Rubydangoday/Project_IOT_clicker/docs/KY_THUAT_CHI_TIET.md

> **Ghi chú bố cục repo Project_IOT_clicker:** tài liệu này viết theo bố cục cũ. Đối chiếu đường dẫn: `db/` → `database/`; `bridge/`, `ingest/`, `common/`, `history/` → `server/bridge/`, `server/ingest/`, `server/common/`, `server/history/`; `huong-dan-su-dung/` → `docs/huong-dan-su-dung/`; `mau/`, `de-thi-test/` → `samples/`; các file START_HERE/UPGRADE/CHANGES → `docs/phien-ban/`. Bản đang dùng là **V3.18**: Remote firmware V3.17 truyền bằng **BLE advertising A6 trên LE 1M** (bộ thu `server/bridge/ble_adv.py`, bộ xử lý `server/ingest/ingest_adv.py`); các mục mô tả `ble_scan.py`/GATT bên dưới là lịch sử.

> **V3.18 — quét LE 1M khi khởi động và sửa SQL gateway:** đọc [START_HERE_ADV18.md](phien-ban/START_HERE_ADV18.md). Máy đang chạy V3.17: chạy `sudo bash deploy/update_adv18.sh`. Giữ nguyên firmware V3.17.

> **V3.17 — sửa lịch phát/nhận advertising:** máy đã chạy V3.16 hãy đọc [START_HERE_ADV17.md](phien-ban/START_HERE_ADV17.md), chạy `deploy/update_adv17.sh` và nạp firmware V3.17. Các mục bên dưới là lịch sử phiên bản.

> **V3.16 — nhánh advertising thử nghiệm:** đọc [START_HERE_ADV16.md](phien-ban/START_HERE_ADV16.md). Cần cập nhật cả firmware và dịch vụ server; có backup/rollback. Kiểm thử 50 danh tính phần mềm không chứng minh tải RF 50 remote.

> **V3.15 — nghỉ khi chờ câu hỏi, giữ BLE:** bắt đầu tại [START_HERE_CONNECTED_IDLE.md](phien-ban/START_HERE_CONNECTED_IDLE.md). Nạp firmware V3.15; server giữ nguyên V3.12. V3.14 bên dưới là hướng dẫn nền về chữ đáp án.

> **V3.14 — đáp án bằng chữ:** bắt đầu tại [START_HERE_LETTER_ANSWERS.md](phien-ban/START_HERE_LETTER_ANSWERS.md). Nạp firmware V3.14; server giữ nguyên V3.12.

> V3.13 tự theo câu giáo viên được giữ trong V3.14. Hướng dẫn nền: [START_HERE_AUTO_QUESTION.md](phien-ban/START_HERE_AUTO_QUESTION.md).

> **V3.12 — phòng theo remote:** đọc [START_HERE_REMOTE_ROOM.md](phien-ban/START_HERE_REMOTE_ROOM.md) cho phần server.

> **V3.11 GATT một remote:** bắt đầu tại [START_HERE_GATT.md](phien-ban/START_HERE_GATT.md). Phần BLE Advertising bên dưới là tài liệu bản cũ.

# ARS server — Hệ thống phản hồi lớp học bằng Remote

Phần mềm chạy trên **laptop giáo viên** (server). Học sinh bấm **Remote nRF52840** (Bluetooth Low Energy), **Bluetooth sẵn có của laptop** thu sóng trực tiếp (không cần gateway); server nhận đáp án, kiểm tra hợp lệ, lưu vào MariaDB và hiển thị trên web giáo viên, màn chiếu, cổng học sinh và phụ huynh.

> Nguyên tắc thiết kế: **Remote và bộ thu Bluetooth chỉ truyền/nhận, không quyết định gì.** Mọi kiểm tra hợp lệ, lưu trữ, thống kê đều nằm ở server (`ingest/ingest.py`). Firmware có thể đơn giản, sửa luật chỉ cần sửa server.

Hướng dẫn sử dụng cho giáo viên, học sinh, phụ huynh và lập trình viên: **[huong-dan-su-dung/](huong-dan-su-dung/README.md)**

Tài liệu khác: [HUONG_DAN_CAI_DAT.md](HUONG_DAN_CAI_DAT.md) (cài đặt chi tiết) · [UPGRADE_V10.md](phien-ban/UPGRADE_V10.md) (LMS, phụ huynh) · [UPGRADE_V11.md](phien-ban/UPGRADE_V11.md) (trường, Cloud, thi đua, Zalo/SMS) · [UPGRADE_V12.md](phien-ban/UPGRADE_V12.md) (Google/Facebook, học sinh tự đăng ký) · [tests/README.md](../tests/README.md)

---

## 1. Kiến trúc tổng quan

```
                         LAPTOP GIÁO VIÊN (server, chạy được offline)
 ┌──────────┐  BLE quảng bá  ┌──────────────────┐  MQTT   ┌──────────────┐  SQL  ┌─────────┐
 │ Remote   │──────────────▶│ Bluetooth laptop │───────▶│  ingest.py   │──────▶│ MariaDB │
 │ nRF52840 │◀──────────────│  ble_scan.py     │◀───────│ kiểm tra gói │◀──────│  `ars`  │
 └──────────┘  beacon        │ (dịch vụ ars-ble)│ STATE   │ soạn STATE   │       └────▲────┘
  (mỗi học sinh 1 cái)       └──────────────────┘         └──────────────┘            │ đọc/ghi
                                                                                ┌────┴─────┐
                                                                                │ Web PHP  │ ◀── trình duyệt GV,
                                                                                │ (Apache) │     màn chiếu, HS, PH
                                                                                └──────────┘
```

Phần cứng chỉ có **Remote nRF52840** (mỗi học sinh một cái). Laptop chạy server **dùng Bluetooth của chính nó** (BlueZ) để nghe gói Remote phát ra và phát beacon trạng thái ngược lại — không cần mạch gateway. (Tuỳ chọn: phòng quá rộng thì cắm thêm một nRF52840 làm gateway USB — `bridge.py`, mục 4.3.)

| Thành phần | Vai trò |
|---|---|
| **Remote nRF52840** | Học sinh nhập số ghế (ID), chọn chữ A–J, bấm OK. Phát gói quảng bá LOGIN / ANSWER (mục 4.1); quét beacon của laptop để bật đèn xanh khi server đã nhận. |
| **ble_scan.py** (dịch vụ `ars-ble`) | Bluetooth laptop ⇄ MQTT, không có logic. Quét gói quảng bá, lọc Manufacturer Data của ARS → JSON → `ars/<room>/resp`; nhận lệnh STATE/ATTEND/OPENMASK/ACKS → phát **4 gói beacon** song song qua BlueZ. `sudo ars ble` in mọi gói nghe được để kiểm tra firmware. |
| **bridge.py** / **gateway.js** (tuỳ chọn) | Chỉ dùng khi có gateway nRF52840 cắm USB: cầu nối serial ⇄ MQTT (`sudo ars gateway usb`), hoặc qua trình duyệt (Web Serial) khi gateway cắm vào máy GV khác. |
| **Mosquitto** | MQTT broker: 1883 (chỉ trong máy), 9001 WebSocket có mật khẩu (qua Apache `/mqtt`, chỉ cho gateway USB tuỳ chọn cắm vào máy giáo viên). Không mở cổng MQTT ra mạng LAN. |
| **ingest.py** | "Trái tim": kiểm tra gói, ghi CSDL, soạn trạng thái gửi ngược cho Remote, tự đóng câu hết giờ. |
| **MariaDB** | Lưu toàn bộ dữ liệu (lớp, câu hỏi, buổi học, đáp án, LMS…). |
| **Web PHP** | Giáo viên điều khiển buổi học, màn chiếu, báo cáo; cổng học sinh / phụ huynh. **Web không nói MQTT**: chỉ ghi DB và tăng `sessions.state_rev`. |

---

## 2. Cây thư mục

```
ars-server/
├── README.md                     Tài liệu này
├── HUONG_DAN_CAI_DAT.md          Hướng dẫn cài đặt & vận hành chi tiết (Ubuntu, Windows, link cố định, Bluetooth / Remote nRF52840)
├── huong-dan-su-dung/            Hướng dẫn sử dụng: giáo viên, học sinh, phụ huynh, lập trình viên (README là mục lục)
├── UPGRADE_V10/V11/V12.md        Ghi chú nâng cấp từng phiên bản (migration, tính năng mới, giới hạn)
├── CHANGES_V10.md                Danh sách file thay đổi ở v10
├── config.ini.example            Mẫu cấu hình: DB, MQTT, room, Bluetooth [ble], cổng serial gateway (tuỳ chọn), uploads (chép thành config.ini)
│
├── firmware/
│   ├── ARS_remote_v3_10/         Firmware Remote nRF52840 (Arduino, Adafruit nRF52): bàn phím, LED 2 số, BLE, nhập ghế bằng MODE
│   ├── PROTOCOL_V3_10.md         Giao thức BLE + lịch radio + so sánh V3.9 → V3.10
│   └── TEST_V3_10.md             Quy trình test radio, tiêu chí PASS/FAIL
├── bridge/
│   ├── ble_scan.py               Bluetooth laptop ⇄ MQTT: quét gói Remote, phát beacon trạng thái (BlueZ). Báo gw/status mỗi 5 s
│   ├── blecodec.py               Định dạng byte trên sóng Remote ⇄ laptop (mã hoá / giải mã, dùng cho cả test)
│   └── bridge.py                 (tuỳ chọn) Gateway nRF52840 USB serial ⇄ MQTT. Tự nối lại khi rút/cắm USB
├── ingest/
│   └── ingest.py                 Nhận gói từ MQTT → kiểm tra → ghi DB → phát STATE/ATTEND/OPENMASK/ACKS
├── common/
│   └── arscfg.py                 Dùng chung cho Python: đọc config.ini, kết nối DB, mã hoá bitmap ghế / mặt nạ câu
├── tools/
│   ├── sim_clickers.py           Giả lập N Remote V3.10 ở tầng MQTT (ACK chính xác, gửi lại, thử tải)
│   ├── ble_txn_report.py         Đọc log serial Remote + journalctl → ACK lần đầu / gửi lại / NACK / UPLINK_MISS / ACK_MISS, PASS/FAIL
│   ├── i18n_wrap.py              Công cụ dịch: bọc chuỗi tiếng Việt bằng t()/te(), liệt kê khoá dịch
│   ├── i18n_collect.py           Duyệt mọi trang trên máy chủ thử, liệt kê chữ tiếng Việt chưa có bản dịch
│   └── i18n_static.py            Quét mã nguồn PHP, liệt kê chữ tiếng Việt chưa có bản dịch
│
├── db/
│   ├── schema.sql                Bảng lõi: teachers, classes, students, devices, question_sets, questions, sessions,
│   │                             session_questions, session_logins, responses, rejected, gateways, VIEW final_answers
│   ├── migrate_002_hocsinh.sql   Cổng học sinh: tài khoản HS, bài ôn tập, lượt luyện tập, sổ câu sai
│   ├── migrate_003_*.sql         Buổi học/bài giảng, cài đặt, nhật ký AI, mã tham gia lớp, trợ lý học tập
│   ├── migrate_004_*.sql         Nhiều giáo viên (quản trị, khoá), kiểu kết nối lớp
│   ├── migrate_005_lms.sql       Trường, kho đề, media câu hỏi, ghép Remote ↔ học sinh, bài tập về nhà, phụ huynh
│   ├── migrate_006_*.sql         Admin trường/lớp hành chính, đồng bộ Cloud, thi đua đổi quà, thông báo Zalo/SMS
│   ├── migrate_007_oauth.sql     Đăng nhập Google / Facebook
│   ├── migrate_008_*.sql         Học sinh tự đăng ký chưa cần lớp
│   ├── migrate_009_language.sql  Ngôn ngữ giao diện theo tài khoản (vi / en)
│   ├── migrate_010_tutor_chats.sql  Trợ lý AI: nhiều cuộc trò chuyện, đánh giá 👍/👎
│   ├── migrate_011_set_finalize.sql Bộ câu hỏi: trạng thái Đang soạn / Đã hoàn tất
│   └── migrate_012_nrf_only.sql     Chỉ dùng phần cứng nRF52840 (mọi lớp kết nối Bluetooth)
│
├── deploy/                       Cài đặt & vận hành trên Ubuntu
│   ├── install_ubuntu.sh         Cài một lệnh: Apache+PHP, MariaDB, Mosquitto, Python libs, chép code vào /opt/ars-server
│   ├── ars                       Lệnh tiện ích: ars status | logs | ble | gateway ble/usb | watch | sim | links | public on/off | backup…
│   ├── ars-watch                 Xem CSDL trực tiếp (gói vào/bị loại) trên terminal
│   ├── ars-ingest.service        systemd: chạy ingest.py
│   ├── ars-ble.service           systemd: chạy ble_scan.py (nhóm bluetooth, tự rfkill unblock)
│   ├── ars-bridge.service        systemd (tuỳ chọn, tắt sẵn): bridge.py cho gateway USB (nhóm dialout)
│   ├── ars-mdns.service/.sh      Quảng bá tên ars.local trong LAN
│   ├── apache-ars.conf           Alias /ars → web/, link ngắn /gv /hs, chặn lib/, proxy WebSocket /mqtt
│   └── mosquitto-ars.conf        2 listener MQTT (1883 nội bộ, 9001 WebSocket có mật khẩu)
│
├── web/                          Ứng dụng web PHP (document root /ars)
│   ├── index.php · register.php · forgot.php · logout.php     Đăng nhập / tạo tài khoản / quên mật khẩu giáo viên
│   ├── portal.php · go.php · privacy.php                       Trang chọn vai trò, link ngắn /gv /hs, chính sách quyền riêng tư
│   ├── oauth.php                 Đăng nhập / đăng ký / liên kết bằng Google hoặc Facebook (cả 3 vai trò)
│   ├── dashboard.php             Tổng quan giáo viên
│   ├── classes.php · class.php   Danh sách lớp; một lớp: học sinh, nhập Excel, mã tham gia, bắt đầu buổi, giao ôn tập
│   ├── session.php               BẢNG ĐIỀU KHIỂN BUỔI HỌC (mở/đóng câu, lưới ghế cập nhật mỗi giây)
│   ├── projector.php             Màn chiếu cho cả lớp (câu hỏi, đồng hồ, biểu đồ khi GV cho hiện)
│   ├── gateway.php               Gateway USB cắm máy GV: Web Serial ⇄ MQTT ngay trong Chrome/Edge
│   ├── sessions.php · results.php · export.php   Lịch sử buổi; kết quả (p, D, phương án nhiễu); xuất Excel
│   ├── devices.php · mapping.php Tình trạng Remote (pin, RSSI, gói trùng) & bộ thu Bluetooth; ghép MAC Remote ↔ ghế học sinh
│   ├── sets.php · set.php · compose.php          Ngân hàng câu hỏi; soạn câu; tách câu từ Word/Excel/PDF + trợ lý AI
│   ├── media.php · question_file.php             Gắn ảnh/audio/video vào câu hỏi; phục vụ tệp có kiểm tra quyền
│   ├── library.php · variants.php                Kho đề dùng chung (riêng/trường/công khai); tạo mã đề đảo câu/phương án
│   ├── set_export.php · set_docx.php · set_print.php · template*.php   Xuất đề Excel/Word/PDF; file mẫu
│   ├── lessons.php · lesson.php · file.php       Buổi học: bài giảng, kiến thức trọng tâm, câu củng cố; tải bài giảng
│   ├── homework.php · homework_grade.php · lms_file.php   Bài tập về nhà; chấm (AI gợi ý); tệp bài làm
│   ├── analytics.php · cohort.php                Báo cáo & ma trận chủ đề; tổng hợp lớp hành chính (GV chủ nhiệm)
│   ├── family.php                Mã mời phụ huynh, nhận xét, khối lớp
│   ├── rewards.php               Thi đua: bảng xếp hạng, cửa hàng quà, duyệt quà
│   ├── school.php · schools.php · teachers.php   Admin trường; quản trị trường; quản trị giáo viên
│   ├── sync.php · notify.php     Đồng bộ lên Cloud; cấu hình & nhật ký Zalo/SMS
│   ├── settings.php · practice_log.php           Cài đặt (AI, đường dẫn, kết nối clicker Bluetooth, Google/Facebook); lịch sử luyện tập HS
│   ├── api/
│   │   ├── state.php             JSON trạng thái buổi học (bảng điều khiển & màn chiếu gọi mỗi giây)
│   │   ├── action.php            Lệnh điều khiển: mở/đóng/chiếu câu, hiện kết quả, giải phóng ghế, kết thúc → tăng state_rev
│   │   ├── qparse.php · qadd.php · ai.php        Tách câu hỏi; thêm câu vào bộ; trợ lý AI soạn câu / tóm tắt
│   │   └── sync.php              Cloud nhận dữ liệu từ server lớp học (xác thực bằng mã đồng bộ)
│   ├── student/                  Cổng học sinh: home, homework, wrong/right (câu sai/đúng), practice/quiz/review,
│   │                             lectures/lecture, lessons (rút kinh nghiệm), tutor + api_tutor (AI), rewards, register…
│   ├── parent/                   Cổng phụ huynh: index (đăng nhập/đăng ký bằng mã mời), home (tiến độ của con)
│   ├── lang/en.php               Từ điển tiếng Anh (khoá = câu tiếng Việt trong mã)
│   ├── lib/                      Thư viện PHP (bị chặn truy cập trực tiếp):
│   │   ├── i18n.php              Đa ngôn ngữ: t()/te(), chọn ngôn ngữ (?lang=en|vi, cookie, theo tài khoản), dịch toàn trang i18n_html()
│   │   ├── bootstrap.php         Cấu hình, PDO, phiên, CSRF, quyền sở hữu lớp/buổi, giao diện chung, bump_state()
│   │   ├── student.php · lms.php Dùng chung cổng HS; bài tập về nhà, tệp, phụ huynh
│   │   ├── stats.php · sheet.php Thống kê buổi học; đọc/ghi .xlsx/.csv không cần thư viện
│   │   ├── qparse.php · qbank.php · extract.php · variants.php   Tách câu, lưu câu, đọc chữ PDF/PPTX/DOCX, mã đề
│   │   ├── ai.php · ai_offline.php · tutor.php   Trợ lý AI (Claude/OpenAI/Ollama hoặc offline); trợ lý học sinh
│   │   ├── school.php · rewards.php · sync.php · notify.php · oauth.php · auth_ui.php   Tính năng v11–v12
│   │   └── settings_links.php    Phần Đường dẫn / Kết nối clicker của trang Cài đặt
│   └── assets/                   CSS/JS: style.css, student.css, control.js (bảng điều khiển), projector.js,
│                                 gateway.js (Web Serial), fx.js (hiệu ứng), capture.js (vẽ/ghi âm), math.js + vendor/ (KaTeX, mqtt.js, qrcode)
│
├── tests/                        Test tích hợp chạy trên CSDL tạm: `bash tests/run_local.sh` (xem tests/README.md)
└── mau/                          Tệp mẫu: đề Word, dữ liệu thử Excel, bài giảng PDF
```

---

## 3. Workflow: từ lúc Remote bấm đến lúc dữ liệu được lưu

### 3.1 Trước buổi học
1. Giáo viên tạo **lớp** với **mã lớp (room, 1–255)** và danh sách học sinh (**số ghế 1–99** = ID học sinh gõ trên Remote).
2. Laptop phải phục vụ đúng room đó: `config.ini → [gateway] room` (dùng cho `ble_scan.py`; khi Remote đổi room thì gói vẫn được chuyển đúng `ars/<room>/resp`, nhưng beacon trạng thái chỉ phát cho room này).
3. Giáo viên bấm **Bắt đầu** → tạo dòng `sessions` (status `running`). Mỗi room chỉ có **một buổi đang chạy**.

### 3.2 Điểm danh (LOGIN)
```mermaid
sequenceDiagram
    participant R as Remote (nRF)
    participant L as Bluetooth laptop (ble_scan.py)
    participant I as ingest.py
    participant D as MariaDB
    R->>L: BLE quảng bá: LOGIN (room, id=ghế, seq), đợt 150 ms
    L->>I: MQTT ars/<room>/resp {"mac","room","type":1,"id",...,"via":"ble","ts"} (QoS 1)
    I->>D: UPSERT devices (pin, RSSI, last_seen)
    I->>D: kiểm tra buổi, ghế, ghép MAC → INSERT session_logins
    I->>L: MQTT ars/<room>/cmd/gw: ATTEND <bitmap>
    L-->>R: beacon ATTEND chứa bitmap điểm danh → Remote thấy bit của mình → báo đã điểm danh
```

### 3.3 Trả lời câu hỏi (ANSWER)
1. GV bấm **Mở câu** trên `session.php` → `api/action.php` ghi `session_questions` (status `open`, `deadline` theo đồng hồ MariaDB `NOW(3)`) → **tăng `sessions.state_rev`**.
2. `ingest.py` (vòng `state_loop`, mỗi 0,3 s) thấy `state_rev` đổi → phát `STATE <room> <qid> 1 <n_options> <bitmap>` + `OPENMASK` → laptop phát beacon → Remote biết câu `qid` đang mở.
3. Học sinh chọn chữ, bấm OK → Remote phát ANSWER (`q` = số thứ tự câu trong bộ, `ans`, `seq` mới) trong một đợt 150 ms.
4. Laptop nghe gói (một hoặc nhiều bản lặp) → `ble_scan.py` → `ars/<room>/resp` → ingest **kiểm tra theo thứ tự**:

   | # | Kiểm tra | Lý do loại (`rejected.reason`) |
   |---|---|---|
   | 1 | Đủ trường, kiểu đúng, MAC 17 ký tự, type 1/2, room 0–255 | `malformed` |
   | 2 | Room có buổi đang chạy | `no_session` |
   | 3 | Gói phải đến qua Bluetooth (`via` = `ble`) | `wrong_link` |
   | 4 | Nếu ghế/MAC đã ghép cố định (mapping.php) thì phải khớp | `mapping_mismatch` |
   | 5 | MAC đã điểm danh, và đúng ghế đã điểm danh | `not_logged_in` · `id_mismatch` |
   | 6 | Câu `q` đã được mở trong buổi | `q_not_open` |
   | 7 | **Gói trùng** (cùng câu, MAC, seq) → bỏ qua, chỉ đếm `devices.pkt_dup` | (không phải lỗi) |
   | 8 | Câu còn mở, chưa quá hạn | `q_closed` · `late` |
   | 9 | Chữ nằm trong số lựa chọn của câu | `bad_option` |
   | 10 | Nếu buổi không cho đổi đáp án: ghế chưa trả lời câu này | `no_change` |

   (LOGIN có thêm: `unknown_seat` ghế không có trong lớp, `seat_taken` ghế đã có máy khác, `mac_bound` máy đã gắn ghế khác.)
5. Hợp lệ → ghi `responses` → bản ghi **ACK chính xác** `(ghế, câu, seq, đáp án, status 0)` của ghế đó, phát ngay trong gói ACKS. Bị loại → bản ghi **NACK** cùng định danh, `status` = mã lý do.
6. Remote thấy bản ghi **khớp đúng ghế + câu + seq + đáp án** → đèn xanh (NACK → đèn đỏ, Serial in lý do). STATE không bao giờ được dùng làm ACK. Không thấy trong 1 s → nghỉ ngẫu nhiên rồi gửi lại **cùng seq** (tối đa 4 lần); server coi là trùng, không ghi 2 lần, chỉ gia hạn ACK.
7. Bảng điều khiển và màn chiếu đọc `api/state.php` mỗi giây → ô học sinh chuyển xanh, biểu đồ cập nhật.
8. Hết giờ: `ingest` tự đóng câu (`status=closed`) và phát STATE `open=0`. GV bấm **Kết thúc buổi** → `sessions.status=ended`.

### 3.4 Lưu trữ
| Bảng | Nội dung |
|---|---|
| `devices` | Mỗi MAC: pin (mV), RSSI, room/ghế gần nhất, lần cuối thấy, tổng gói, gói trùng |
| `session_logins` | Điểm danh: (buổi, ghế, MAC, thời điểm) — duy nhất theo ghế và theo MAC |
| `responses` | **Mọi lượt bấm hợp lệ** (kể cả đổi đáp án): ghế, MAC, seq, chữ, RSSI, thời điểm ms |
| `final_answers` (VIEW) | Đáp án cuối của mỗi ghế cho mỗi câu = lượt có `id` lớn nhất — dùng cho chấm điểm, thống kê |
| `rejected` | Gói bị loại + lý do + bản gốc (gộp 5 bản lặp của một lần bấm thành 1 dòng trong 10 s) |
| `gateways` | Trạng thái bộ thu (Bluetooth laptop / gateway USB) theo room: online, gói/giây, cổng, cập nhật lúc |
| `sessions`, `session_questions` | Buổi học, câu đã mở/đóng, hạn giờ, `state_rev`, `show_result` |

Sau buổi học, kết quả được dùng cho: trang Kết quả, báo cáo/ma trận chủ đề, sổ câu sai của học sinh, điểm thi đua, tin Zalo/SMS cho phụ huynh, đồng bộ lên Cloud (`sync.php`).

---

## 4. Giao thức truyền / nhận

### 4.1 Remote ⇄ Laptop (BLE quảng bá, không kết nối)
- Remote **phát gói quảng bá** (advertising) LOGIN/ANSWER; laptop **quét** (BlueZ, `ble_scan.py`) — không ghép đôi, không kết nối GATT, nên cả lớp gửi cùng lúc được.
- Laptop **phát beacon** (quảng bá non-connectable) chứa trạng thái; mọi Remote cùng quét để biết câu đang mở và đã được nhận chưa.
- Một lần bấm OK = **1 seq**: một đợt quảng bá 150 ms (≈ 6 sự kiện) rồi nghe ACK 1 s; chưa có thì gửi lại cùng seq (tối đa 4 lần). Bấm lần mới → seq tăng (0–255, quay vòng). Chi tiết lịch radio: [firmware/PROTOCOL_V3_10.md](../firmware/PROTOCOL_V3_10.md).
- Định danh Remote = **địa chỉ BLE** của nó → firmware dùng địa chỉ **random static** cố định (mặc định của nRF52840), không bật privacy (địa chỉ đổi liên tục sẽ bị coi là máy khác).
- Dữ liệu nằm trong **Manufacturer Specific Data** (AD type `0xFF`), mã công ty `[ble] company_id` (mặc định `0xFFFF` — mã thử nghiệm), byte đầu `0xA5`. Mã nguồn tham chiếu: `bridge/blecodec.py`.

**Remote → laptop** (9 byte sau mã công ty):

| Byte | Ý nghĩa |
|---|---|
| 0 | `0xA5` (dấu nhận diện ARS) |
| 1 | type: `1` = LOGIN, `2` = ANSWER |
| 2 | room (0–255) |
| 3 | số ghế / ID (1–99) |
| 4 | câu q (1–64; LOGIN: 0) |
| 5 | seq (0–255) |
| 6 | đáp án: `0` = không có, `1`–`10` = A–J (hoặc mã ASCII `'A'`–`'J'`) |
| 7–8 | pin mV, uint16 little-endian (`0` = không đo) |

Ví dụ ghế 7, room 1, câu 3, seq 12, chọn B, pin 2950 mV: company `0xFFFF`, data `A5 02 01 07 03 0C 02 86 0B`.
Trong firmware nRF5 SDK / Zephyr: `BT_DATA(BT_DATA_MANUFACTURER_DATA, {0xFF,0xFF, 0xA5,0x02,0x01,0x07,0x03,0x0C,0x02,0x86,0x0B}, 11)`.

**Laptop → Remote** (beacon, cùng mã công ty; ACKS ưu tiên, STATE/ATTEND/OPENMASK phát thành burst ngắn khi không có ACK):

| Gói | Byte |
|---|---|
| STATE | `A5 10` room qid open(0/1) **n_options** + bitmap 13 byte ghế **đã có đáp án** câu qid |
| ATTEND | `A5 11` room + bitmap 13 byte ghế **đã điểm danh** |
| OPENMASK | `A5 12` room + 8 byte mặt nạ câu đang mở (câu p ở bit p−1) — cho phím ◀ ▶ |
| ACKS | `A5 13` room n + n bản ghi **(ghế, câu, seq, đáp án, status)**, n ≤ 4 — 4 kết quả mới nhất, mỗi ghế hết hạn sau 1,8 s |

Remote chỉ đọc beacon có room trùng room mình nhớ; dùng `n_options` để chặn tại chỗ đáp án vượt số lựa chọn, ATTEND để xác nhận điểm danh, ACKS để xác nhận đúng giao dịch vừa gửi. Phát beacon cần Linux (BlueZ ≥ 5.50); trên Windows/macOS `ble_scan.py` chỉ nghe.

### 4.2 Dữ liệu gói và lệnh trạng thái
**Dạng JSON** (ble_scan.py giải mã ra, hoặc gateway USB in ra mỗi dòng) — đây là dữ liệu ingest nhận:
```json
{"mac":"C4:1A:00:11:22:33","room":1,"type":2,"id":7,"q":3,"seq":12,"ans":"B","batt":2950,"rssi":-61}
```
| Trường | Kiểu | Ý nghĩa |
|---|---|---|
| `mac` | `AA:BB:CC:DD:EE:FF` | Địa chỉ Remote (định danh thiết bị) |
| `room` | 0–255 | Mã lớp Remote đang nhớ |
| `type` | 1 / 2 | 1 = LOGIN (điểm danh), 2 = ANSWER |
| `id` | 1–99 | Số ghế học sinh nhập |
| `q` | 1–64 | Số thứ tự câu trong bộ (LOGIN: 0) |
| `seq` | 0–255 | Số thứ tự lần bấm (5 bản lặp cùng seq) |
| `ans` | `A`–`J` | Chữ đã chọn (LOGIN: rỗng). Phím 1–9 = A–I, 0 = J |
| `batt` | mV | Điện áp pin (cảnh báo dưới `[ingest] low_batt_mv`, mặc định 2600) |
| `rssi` | dBm | Cường độ sóng bộ thu đo được |

**Lệnh trạng thái** ingest gửi xuống (`ars/<room>/cmd/gw`), bộ thu chuyển thành beacon:
| Lệnh | Ý nghĩa |
|---|---|
| `STATE <room> <qid> <open 0/1> <n_options> <13 byte hex>` | Câu đang chiếu, đang mở hay đóng, số lựa chọn, bitmap ghế **đã có đáp án** câu đó |
| `ATTEND <13 byte hex>` | Bitmap ghế **đã điểm danh** |
| `OPENMASK <8 byte hex>` | Các câu đang mở (câu p ở bit p−1) — cho phím ◀ ▶ chuyển câu trên Remote |
| `ACKS <ghế:câu:seq:đáp_án:status,...>` hoặc `ACKS -` | Kết quả chính xác gần nhất (mỗi ghế 1 bản ghi; gói quảng bá giữ 4 bản ghi mới nhất). `status` 0 = nhận, khác 0 = mã lý do NACK |

**Bitmap:** ghế n ở byte `n ÷ 8`, bit `n mod 8`, bit thấp trước, 13 byte = 104 bit (`common/arscfg.py → bitmap_hex`). Ví dụ ghế 1–4 → `1E000000000000000000000000`.
Server phát lại toàn bộ trạng thái khi có thay đổi (≤ 0,3 s) **và định kỳ mỗi 5 s** (`[ingest] state_refresh_s`), nên bộ thu khởi động lại hay mất một lệnh vẫn tự đúng.

### 4.2b Gateway nRF52840 cắm USB (tuỳ chọn)
Phòng quá rộng so với tầm Bluetooth laptop thì cắm thêm một nRF52840 làm gateway (`sudo ars gateway usb`; quay lại: `sudo ars gateway ble`). **115200 baud, 8N1**: gateway in mỗi gói nghe được thành 1 dòng JSON như mục 4.2 (dòng không bắt đầu bằng `{` là log, bị bỏ qua), nhận mỗi lệnh trạng thái 1 dòng và tự phát beacon.

### 4.3 MQTT (bên trong server)
| Topic | Chiều | QoS | Nội dung |
|---|---|---|---|
| `ars/<room>/resp` | ble_scan.py (hoặc bridge/gateway.js) → ingest | 1 | JSON gói như 4.2, thêm `via` (`ble`), `ts` |
| `ars/<room>/cmd/gw` | ingest → ble_scan.py (hoặc bridge/gateway.js) | 1 | Một lệnh STATE / ATTEND / OPENMASK / ACKS |
| `ars/<room>/state` | ingest → mọi bên | 1, **retain** | JSON trạng thái đầy đủ (`qid, open, answered[], attend[], open_positions[], acks, mode, cmds[]`). Bộ thu vừa khởi động đọc bản giữ lại để phát beacon ngay |
| `ars/<room>/live` | ingest → (tuỳ chọn) | 0 | Số đã trả lời, phân bố đáp án |
| `ars/<room>/gw/status` | ble_scan.py / bridge → ingest | 1, retain | `{"online", "port", "pkt_per_s"}` mỗi 5 s (`port` = `bluetooth hci0` hoặc cổng USB); Last Will = offline |

Phần cứng chỉ dùng **Remote nRF52840** nên mọi gói đều đến qua Bluetooth (`ble_scan.py`, hoặc gateway USB tuỳ chọn); MQTT chỉ mở trong máy (1883) và qua WebSocket `/mqtt` có mật khẩu (chỉ cho gateway USB cắm vào máy giáo viên).

### 4.4 Lưu ý khi sử dụng
- **Room phải khớp**: lớp đang học ↔ `[gateway] room` ↔ room Remote nhớ. Sai room → gói bị loại `no_session`. Đổi room: học sinh nhập lại ID trên Remote.
- **Chỉ nhận gói qua Bluetooth**: gói có `"via"` khác `ble` bị loại `wrong_link`.
- **Bluetooth laptop phải bật**: dịch vụ `ars-ble` tự bỏ chặn (`rfkill unblock bluetooth`) và bật adapter; tắt Bluetooth giữa giờ → Remote không gửi được, web báo "Bluetooth laptop: chưa bật". Tầm thu khoảng 10–20 m trong phòng; đặt laptop giữa lớp hoặc dùng gateway USB (mục 4.2b).
- Kiểm tra Remote mới nạp firmware: `sudo ars ble` in mọi gói quảng bá, dòng `→ ARS {...}` là gói đúng định dạng 4.1.
- **Một ID một máy** trong một buổi. Học sinh đổi Remote giữa giờ → GV bấm ô ghế để **giải phóng ID**, rồi học sinh điểm danh lại.
- **Ghép Remote cố định** (Thiết bị → Ghép Remote) chống mượn máy bấm hộ; đổi ghép ngoài giờ học.
- Tỉ lệ **gói trùng cao là bình thường** (mỗi đợt phát khoảng 6 sự kiện quảng bá cùng seq). Nhiều gói `late`/`q_closed` = học sinh bấm sau khi đóng câu.
- Thời gian (mở câu, hạn giờ, nhận gói) đều lấy theo **đồng hồ MariaDB** — web và ingest không lệch giờ nhau.
- (Gateway USB) rút ra cắm lại: bridge tự nối lại sau 2 s và phát lại trạng thái giữ lại. Linux thường là `/dev/ttyACM0` (người dùng dịch vụ cần nhóm `dialout`); Windows là `COMx` — xem `python bridge/bridge.py --list`.
- Bộ câu dùng với Remote tối đa **64 câu** (mặt nạ OPENMASK 8 byte), lớp tối đa **99 ghế**, câu 2–10 lựa chọn (A–J).
- (Gateway USB) qua trình duyệt (`gateway.php`) cần **Chrome/Edge** và trang mở bằng **https hoặc localhost**; giữ tab mở suốt buổi.
- Xem trực tiếp: `ars logs` (gói vào / bị loại), `ars watch`, trang **Thiết bị** (pin, RSSI, lần cuối thấy), bảng "Gói bị server từ chối" trên bảng điều khiển.

---

## 5. Chạy nhanh

**Ubuntu (khuyên dùng):**
```bash
sudo bash deploy/install_ubuntu.sh        # cài/cập nhật; giữ nguyên config.ini và dữ liệu
ars status                                # apache2, mariadb, mosquitto, bluetooth, ars-ingest, ars-ble
sudo ars ble                              # bấm Remote: thấy dòng '→ ARS' là laptop nghe được
```
Mở `http://localhost/gv` (giáo viên) · `http://localhost/hs` (học sinh) · `/ars/parent/` (phụ huynh). Lần đầu tạo tài khoản quản trị.
Link Internet https: `sudo ars public on` (Tailscale Funnel).

**Cập nhật code đã cài:**
```bash
sudo rsync -a --delete --exclude config.ini --exclude .gateway-usb --exclude .git --exclude '__pycache__' ./ /opt/ars-server/
sudo systemctl restart apache2 ars-ingest ars-ble
```
Có migration mới (`db/migrate_00X_*.sql`) thì chạy trước: `mysql -u root -p ars < db/migrate_00X_….sql`.

**Windows / chạy tay:** XAMPP (Apache + MariaDB) + Mosquitto + Python 3.10 (`pip install paho-mqtt pymysql bleak`); tạo CSDL bằng `schema.sql` rồi lần lượt `migrate_002` → `009`; chép `config.ini.example` → `config.ini`; mỗi buổi chạy `python ingest/ingest.py` và `python bridge/ble_scan.py` (Windows chỉ nghe được Remote, không phát beacon — nên chạy server trên Ubuntu). Chi tiết: [HUONG_DAN_CAI_DAT.md](HUONG_DAN_CAI_DAT.md).

**Không có phần cứng:**
```bash
ars sim 30            # hoặc: python3 tools/sim_clickers.py --room 1 -n 30 [--loss 0.3]
```
Mở bảng điều khiển, bấm **Mở câu** — các ô chuyển xanh dần; cuối chạy bộ giả lập in tỉ lệ xác nhận và độ trễ bấm OK → đèn xanh.

**Test:** `bash tests/run_local.sh` (CSDL tạm, không đụng dữ liệu thật).

---

## 6. Ngôn ngữ giao diện (Tiếng Việt / English)

- Giáo viên và phụ huynh chọn **🇻🇳 VI / 🇬🇧 EN** ở thanh trên (hoặc màn đăng nhập). Lựa chọn lưu theo cookie và theo tài khoản (đăng nhập máy khác vẫn giữ). Lần đầu mở, trình duyệt đặt tiếng Anh sẽ thấy tiếng Anh. Cổng học sinh cũng có nút VI / EN.
- Đã dịch: thanh trên, đăng nhập / đăng ký / quên mật khẩu, Tổng quan, Lớp học, trang lớp, bảng điều khiển + màn chiếu (cả JavaScript), Kết quả, cổng phụ huynh, Google/Facebook. Trang chưa dịch hiện tiếng Việt.
- **Ngôn ngữ khác (Google Dịch):** cuối menu ngôn ngữ, dịch máy toàn bộ trang sang mọi ngôn ngữ Google Dịch hỗ trợ (danh sách lấy trực tiếp từ Google, luôn mới). Cần Internet; script Google chỉ tải khi người dùng chọn; nội dung trang (kể cả tên, điểm học sinh) được gửi tới Google — quản trị tắt được ở Cài đặt → Thông tin chung. Chữ cái đáp án, phím Remote, số ghế, tên ARS gắn `translate="no"`.
- Thêm bản dịch: bọc chuỗi bằng `t('…')` / `te('…')` (PHP) hoặc `T('…')` (JS, trong control.js / projector.js); biến dạng `{n}`. `python3 tools/i18n_wrap.py keys web` liệt kê mọi khoá → thêm vào `web/lang/en.php`.
- Dịch toàn trang: khi chọn tiếng Anh, `i18n_html()` lọc HTML trước khi gửi (chữ giữa các thẻ, placeholder/title, confirm) và `assets/i18n.js` dịch chữ do JavaScript chèn vào — cùng từ điển `web/lang/en.php`, số trong câu viết `{n}`. Tìm chữ còn sót: `KEEP=1 bash tests/run_local.sh` rồi `python3 tools/i18n_collect.py /tmp/ars-test.XXXX/smoke.json` (thêm `EN=1` để xem chữ Việt còn sót trên giao diện tiếng Anh).

## V3.18 ADV18 + Cloud/Web (merge 2026-10-15)

This distribution preserves V3.18 Advertising A6/LE 1M and adds Cloud, attendance, parent accounts and teacher verification. **For a running ADV18 server, do not run a wholesale `git pull` + `install_ubuntu.sh` before reading** [`HUONG_DAN_TICH_HOP_V318_CLOUD.md`](phien-ban/HUONG_DAN_TICH_HOP_V318_CLOUD.md). Use `sudo bash deploy/upgrade_web_cloud_v318.sh` from the extracted merged project instead. Existing firmware, BLE bridge, ingest, PHY and HCI service drop-ins are not changed by that upgrade script. Cloud VPS: `install_ubuntu.sh --cloud`.
