Rubydangoday/Project_IOT_clicker/docs/huong-dan-su-dung/hoc-sinh.md

# Hướng dẫn cho học sinh

[← Mục lục](README.md)

## Mục lục
1. [Dùng Remote trên lớp](#1-dùng-remote-trên-lớp)
2. [Đăng nhập trang học sinh](#2-đăng-nhập-trang-học-sinh)
3. [Vào lớp học](#3-vào-lớp-học)
4. [Các mục trong trang học sinh](#4-các-mục-trong-trang-học-sinh)
5. [Bài tập về nhà](#5-bài-tập-về-nhà)
6. [Ôn tập, câu sai và rút kinh nghiệm](#6-ôn-tập-câu-sai-và-rút-kinh-nghiệm)
7. [Trợ lý AI Cú Học](#7-trợ-lý-ai-cú-học)
8. [Thi đua, điểm thưởng và quà](#8-thi-đua-điểm-thưởng-và-quà)
9. [Câu hỏi thường gặp](#9-câu-hỏi-thường-gặp)

---

## 1. Dùng Remote trên lớp

Remote có màn hình 2 số, đèn đỏ/xanh và 14 phím:

| Phím | Dùng để |
|---|---|
| `1/A` … `9/I`, `0/J` | Nhập số ghế; chọn đáp án (1 = A, 2 = B, …, 9 = I, 0 = J) |
| **◀ LEFT** / **▶ RIGHT** | Chuyển giữa các câu thầy cô đang mở |
| **OK** | Gửi (điểm danh hoặc đáp án) |
| **MODE** | Nhập số ghế (bấm MODE hai lần: nhập room) |

**Nhìn màn hình và đèn để biết Remote đang ở chế độ nào:**

| Màn hình | Đèn | Đang ở chế độ |
|---|---|---|
| Số đứng yên, ví dụ `03` | tắt | Bình thường: đang ở **câu 3** |
| `Gh` rồi đến số (hoặc `--`), lặp lại | **xanh** nháy chậm | **Nhập số ghế** (vừa bấm MODE) |
| `Ph` rồi đến số, lặp lại | **đỏ** nháy chậm | **Nhập phòng (room)** (bấm MODE lần nữa) |
| Một **chữ cái nhấp nháy** ở ô trái: `A`, `b`, `C`, `d`, `E`, `F`, `G`, `H`, `I`, `J` | tắt | **Đã chọn đáp án, CHƯA gửi** — bấm OK |
| Chữ cái **đứng yên** | tắt | Đang gửi, chờ máy chủ |
| Quay về số câu | **xanh** chớp | Máy chủ đã nhận đáp án |
| — | **đỏ** chớp | Bị từ chối hoặc không liên lạc được (chữ cái nhấp nháy lại = bấm OK để gửi lại) |

**Điểm danh (đầu giờ)**
1. Gạt công tắc để bật Remote. Remote nhớ số ghế của lần trước và tự điểm danh lại.
2. Lần đầu (màn hình hiện `Gh` / `--`, đèn xanh nháy) hoặc khi đổi chỗ: bấm **MODE**, gõ **số ghế** (thầy cô cho biết, 1–99), bấm **OK**. Bấm MODE rồi OK ngay (không gõ) là điểm danh lại với số ghế cũ.
3. **Đèn xanh** nghĩa là máy chủ đã nhận, bạn đã điểm danh. Lớp dùng room khác 1: bấm MODE hai lần, gõ room thầy cô cho, OK, rồi gõ số ghế, OK.

**Trả lời câu hỏi**
1. Khi thầy cô bấm *Mở câu*, màn hình Remote hiện số câu.
2. Bấm phím đáp án (ví dụ `2/B` để chọn B) — màn hình hiện chữ `b` nhấp nháy — rồi bấm **OK**.
3. **Đèn xanh** nghĩa là đáp án đã được nhận. Nếu thầy cô cho phép đổi đáp án, bạn chọn lại và bấm **OK** trước khi câu đóng.

**Lưu ý**
- Mỗi Remote chỉ dùng cho **một số ghế** trong một buổi. Đổi Remote giữa giờ thì báo thầy cô để giải phóng số ghế.
- Bấm **OK** một lần là đủ: Remote tự gửi lại (tối đa 4 lần) tới khi máy chủ xác nhận đúng lần bấm đó. **Đèn đỏ** là máy chủ từ chối (ví dụ câu đã đóng) hoặc không liên lạc được.
- Bấm sau khi câu đã đóng thì đáp án không được tính.
- Tắt Remote sau giờ học để tiết kiệm pin.

---

## 2. Đăng nhập trang học sinh

Ở nhà hoặc dùng 4G: mở **https://<may-chu>.<tailnet>.ts.net/hs**. Trong lớp (cùng Wi-Fi với máy chủ): `http://ars.local/hs` hoặc quét mã QR thầy cô chiếu.

**Đã có tên trong danh sách lớp:**
- Đăng nhập bằng **MSSV**. **Lần đầu, mật khẩu chính là MSSV**; hệ thống sẽ bắt đổi mật khẩu mới ngay.

**Chưa có tài khoản:**
- Bấm **Tạo tài khoản mới**, nhập MSSV, họ tên, mật khẩu.
- Có **mã tham gia lớp** thì nhập luôn; chưa có thì vào lớp sau.

**Khác:**
- Có thể đăng nhập bằng Google nếu trường đã bật.
- **Quên mật khẩu**: nhờ thầy cô bấm "đặt lại MK" trong danh sách lớp.
- Đổi mật khẩu: bấm ảnh đại diện góc phải → **🔑 Đổi mật khẩu**.
- Nút **VI / EN** ở góc trên đổi tiếng Việt / tiếng Anh.

---

## 3. Vào lớp học

Ở **Tổng quan**, khung **🏫 Vào lớp học**: nhập **mã tham gia lớp** 6 ký tự thầy cô cho (ví dụ `FDDC78`). Mở link dạng `…/hs/FDDC78` hoặc quét QR thì mã được điền sẵn.

Bạn có thể vào nhiều lớp (mỗi môn một lớp). Khi vào lớp, bạn được cấp **số ghế**: đó là số nhập trên Remote.

---

## 4. Các mục trong trang học sinh

Thanh bên trái (trên điện thoại là menu):

| Nhóm | Mục | Nội dung |
|---|---|---|
| Học tập | 🏠 **Tổng quan** | Việc cần làm, điểm các buổi gần đây, phần cần ôn kỹ, bài giảng mới, lớp của tôi |
| | 🏡 **Bài tập về nhà** | Bài thầy cô giao, nộp bài, xem điểm |
| | 📚 **Bài giảng** | File bài giảng từng buổi, xem trực tiếp trên web |
| | 🎯 **Ôn tập** | Bài ôn được giao, ôn câu sai, ôn theo chủ đề, làm lại bài của một buổi |
| | 🦉 **Trợ lý AI** | Hỏi Cú Học về bài học |
| Kết quả của tôi | ❌ **Câu sai** | Câu đã làm sai, đáp án đúng, ghi lý do sai |
| | ✅ **Câu đúng** | Câu đã làm đúng |
| | 📝 **Rút kinh nghiệm** | Nhìn lại từng buổi: điểm, phần yếu, nguyên nhân sai, kế hoạch ôn |
| Cộng đồng | 🏆 **Thi đua** | Bảng xếp hạng, đổi quà, bộ sưu tập avatar |

Góc trên hiện **⭐ điểm thưởng**, **🔥 chuỗi ngày học liên tiếp** và **cấp độ**. Học đều mỗi ngày để giữ chuỗi.

---

## 5. Bài tập về nhà

1. Mở **🏡 Bài tập về nhà**, chọn bài.
2. Làm ngay trên điện thoại hoặc máy tính. Bài có thể gồm:
   - **Trắc nghiệm**: chọn đáp án.
   - **Tự luận**: gõ bài làm, có thể chèn công thức.
   - **Vẽ tay**: vẽ trên khung, bấm **Đính kèm hình vẽ** (**Xóa nét vẽ** để vẽ lại).
   - **Ghi âm**: bấm ghi, rồi **Dừng và đính kèm**.
3. **Lưu nháp** để làm tiếp sau; nhớ **nộp trước hạn**.
4. Trạng thái bài: *Chưa nộp* → *Đã nộp · chờ chấm* → *Đã có điểm*. Khi thầy cô công bố, bạn thấy điểm và nhận xét từng câu.

---

## 6. Ôn tập, câu sai và rút kinh nghiệm

**🎯 Ôn tập**
- **Giáo viên giao**: bài ôn thầy cô giao (bấm **Làm tiếp** nếu đang làm dở).
- **Ôn lại câu sai**: hệ thống hỏi lại các câu bạn sai hoặc bỏ trống.
- **Theo chủ đề**: chọn chủ đề muốn luyện.
- **Làm lại bài của một buổi**: hữu ích khi bạn vắng buổi đó.
- **Lịch sử ôn tập**: các lượt đã làm.

**❌ Câu sai**
- Xem đáp án đúng và lời giải, chọn **nguyên nhân sai**, ghi **ghi chú rút kinh nghiệm**.
- Câu sai được hỏi lại đến khi bạn trả lời đúng; **đúng 2 lần liên tiếp** thì được tính là **"đã thuộc"**.
- Nút **🦉 Hỏi Cú Học vì sao sai** mở trợ lý AI giải thích riêng câu đó.

**📝 Rút kinh nghiệm**: tổng kết từng buổi (điểm của bạn, trung bình lớp, phần yếu theo chủ đề). Có nút **In / lưu PDF**.

---

## 7. Trợ lý AI Cú Học

Mở **🦉 Trợ lý AI**:
- Hỏi bất cứ điều gì về bài học: giải thích lại, cho ví dụ, ra câu hỏi ôn, lập kế hoạch học.
- Chọn phạm vi (**một buổi học** hoặc **tất cả bài đã học**) và **trình độ** để câu trả lời vừa sức.
- Gợi ý nhanh (nút bên dưới khung chat) và mục **Phần cần củng cố** giúp bạn bắt đầu.
- **＋ Trò chuyện mới** mở cuộc trò chuyện mới; các cuộc cũ được lưu ở cột bên trái. **Xoá toàn bộ lịch sử** nếu muốn.

Lưu ý:
- Khi bạn đang làm **bài kiểm tra**, trợ lý **tạm khoá** đến khi nộp bài.
- Cú Học có thể nhầm. Hãy đối chiếu với bài giảng và hỏi thầy cô khi chưa chắc.

---

## 8. Thi đua, điểm thưởng và quà

- Bạn nhận **⭐ điểm** khi trả lời đúng trên Remote và làm bài tập về nhà.
- **Bảng xếp hạng** theo tuần/tháng trong lớp.
- **Đổi quà**: dùng điểm đổi món quà thầy cô đặt trong cửa hàng của lớp; thầy cô xác nhận khi trao.
- **Bộ sưu tập**: đổi điểm lấy avatar, hoặc dùng chữ cái tên.
- Đạt mốc sẽ nhận **huy hiệu** (hiện thông báo 🏅).

---

## 9. Câu hỏi thường gặp

**Bấm OK mà đèn không xanh.**
- Kiểm tra số ghế nhập đúng chưa.
- Kiểm tra câu đã được mở chưa.
- Ngồi gần laptop của thầy cô hơn.
- Nếu vẫn không được, báo thầy cô xem lý do trên bảng điều khiển.

**Báo "ghế đã có máy khác".** Có Remote khác đã điểm danh số ghế của bạn. Báo thầy cô giải phóng ghế.

**Đăng nhập báo "MSSV này chưa có tài khoản".** Bạn chưa có trong danh sách lớp, bấm **Tạo tài khoản mới**.

**Vắng một buổi.** Vào **Ôn tập → Làm lại bài của một buổi**, và xem **Bài giảng** của buổi đó.
