Rubydangoday/Project_IOT_clicker/docs/huong-dan-su-dung/phu-huynh.md

# Hướng dẫn cho phụ huynh

[← Mục lục](README.md)

Trang phụ huynh giúp bạn xem con học thế nào trên lớp: điểm từng buổi, chuyên cần, bài tập về nhà, kiến thức con còn yếu và nhận xét của thầy cô. Phụ huynh **chỉ xem**, không sửa được điểm hay bài làm.

## 0. Đăng nhập bằng số điện thoại (thầy cô cấp tài khoản)

Nếu thầy cô gửi cho bạn **số điện thoại + mật khẩu lần đầu**:
1. Mở trang phụ huynh: **https://<may-chu>.<tailnet>.ts.net/ars/parent/** hoặc link thầy cô gửi.
2. Ô **Số điện thoại hoặc tên đăng nhập**: nhập SĐT của bạn (ví dụ `0912345678`). Ô **Mật khẩu**: nhập mật khẩu trên phiếu.
3. Lần đầu, trang sẽ yêu cầu **đổi mật khẩu**: đặt mật khẩu riêng (từ 8 ký tự, có cả chữ và số), nhập lại một lần nữa rồi bấm **Lưu mật khẩu mới**.
4. Từ lần sau, đăng nhập bằng SĐT và mật khẩu mới. Nếu có nhiều con trong trường mà cùng SĐT phụ huynh, cả hai con đều hiện trong một tài khoản.

Muốn đổi mật khẩu sau này: vào tab **Tài khoản**, mục **Đăng nhập và mật khẩu**, bấm **Đổi mật khẩu**. Quên mật khẩu: nhờ thầy cô **cấp lại mật khẩu**.

Nếu thầy cô gửi **mã mời** thay vì SĐT và mật khẩu, làm theo mục 1 và 2 dưới đây.

## 1. Nhận mã mời

Thầy cô gửi riêng cho bạn một **mã mời** cho từng con:
- Dạng **8 ký tự** (ví dụ `K7PM-3QXA`), kèm **mã QR**; có thể in trên phiếu mời con mang về.
- Mã có hiệu lực **7 ngày** và chỉ dùng **một lần**. Hết hạn thì xin thầy cô mã mới.

## 2. Tạo tài khoản

1. Mở trang phụ huynh: **https://<may-chu>.<tailnet>.ts.net/ars/parent/** (dùng ở nhà, Wi-Fi hay 4G đều được) hoặc link thầy cô gửi. Quét mã QR trên phiếu mời thì mã được điền sẵn.
2. Chọn **Đăng ký bằng mã mời**, nhập:
   - **Mã mời**.
   - **Họ tên**.
   - **Tên đăng nhập**: 3–50 ký tự, không dấu.
   - **Mật khẩu**: từ 10 ký tự trở lên.
3. Bấm **Tạo tài khoản**. Tài khoản tự liên kết với con.

Nếu nhà trường đã bật, bạn có thể **đăng nhập bằng Google** thay cho mật khẩu (vẫn cần mã mời ở lần đầu).

**Có nhiều con hoặc con học nhiều lớp:** đăng nhập, vào tab **Liên kết**, nhập thêm mã mời ở mục **Liên kết thêm con / lớp**.

## 3. Trang theo dõi

Sau khi đăng nhập, tab **Tổng quan** có:

| Mục | Xem được gì |
|---|---|
| 🔔 **Thông báo** | Sau mỗi buổi học / kiểm tra bằng Remote: con **có mặt / vắng / vắng có phép**, kèm điểm khi thầy cô đã công bố. Tin mới được tô màu và có nhãn *mới* |
| 👪 **Con đã liên kết** | Chọn con muốn xem (nếu có nhiều con); hạng trong lớp, tỉ lệ chuyên cần, điểm 3 buổi gần nhất, số bài chưa nộp |
| 📈 **Tiến độ theo ngày / tuần** | Biểu đồ điểm theo thời gian |
| 🗓 **Điểm và chuyên cần trên lớp** | Từng buổi: ngày, bài, có mặt hay vắng, điểm thang 10 |
| 📝 **Bài tập về nhà** | Bài đã giao, hạn nộp, đã nộp chưa, điểm và nhận xét khi thầy cô công bố |
| 🧠 **Kiến thức trên lớp** | Chủ đề con làm tốt / còn yếu, để nhắc con ôn |
| 💬 **Nhận xét giáo viên** | Nhận xét thầy cô gửi riêng cho con |
| 📚 **Tài liệu bài giảng** | Bài giảng các buổi, để cùng con xem lại |

Khi thầy cô sửa điểm danh hoặc công bố điểm bài kiểm tra, thông báo của buổi đó được cập nhật và hiện lại là *mới*. Thông báo trong web luôn miễn phí và không cần Zalo / SMS.

Góc trên có nút **VI / EN** đổi ngôn ngữ.

## 4. Nhận kết quả qua Zalo / SMS

Nếu nhà trường đã bật kênh thông báo, ở mục **📨 Nhận kết quả buổi học**:
1. Chọn **Kênh nhận tin**: Zalo, SMS hoặc *Không nhận*.
2. Nhập **số điện thoại**, bấm **Lưu**.

Nếu mục này báo *"Nhà trường chưa bật kênh thông báo Zalo / SMS"*, bạn vẫn xem đầy đủ trên web.

## 5. Câu hỏi thường gặp

**Mã mời báo hết hạn hoặc không đúng.**
Mã chỉ dùng được một lần trong 7 ngày. Xin thầy cô mã mới. Chữ hoa hay thường, có dấu gạch ngang hay không đều được.

**Quên mật khẩu.**
Nhờ thầy cô cấp **mã mời mới**, rồi đăng ký lại bằng mã đó.

**Không thấy điểm bài tập.**
Thầy cô chưa **công bố** kết quả bài đó. Điểm hiện sau khi công bố.

**Con vắng buổi học.**
Bảng chuyên cần ghi vắng. Con có thể làm lại bài của buổi đó trong mục *Ôn tập* của trang học sinh.
