Rubydangoday/Project_IOT_clicker/hardware/kicad/previews/Schematic.png

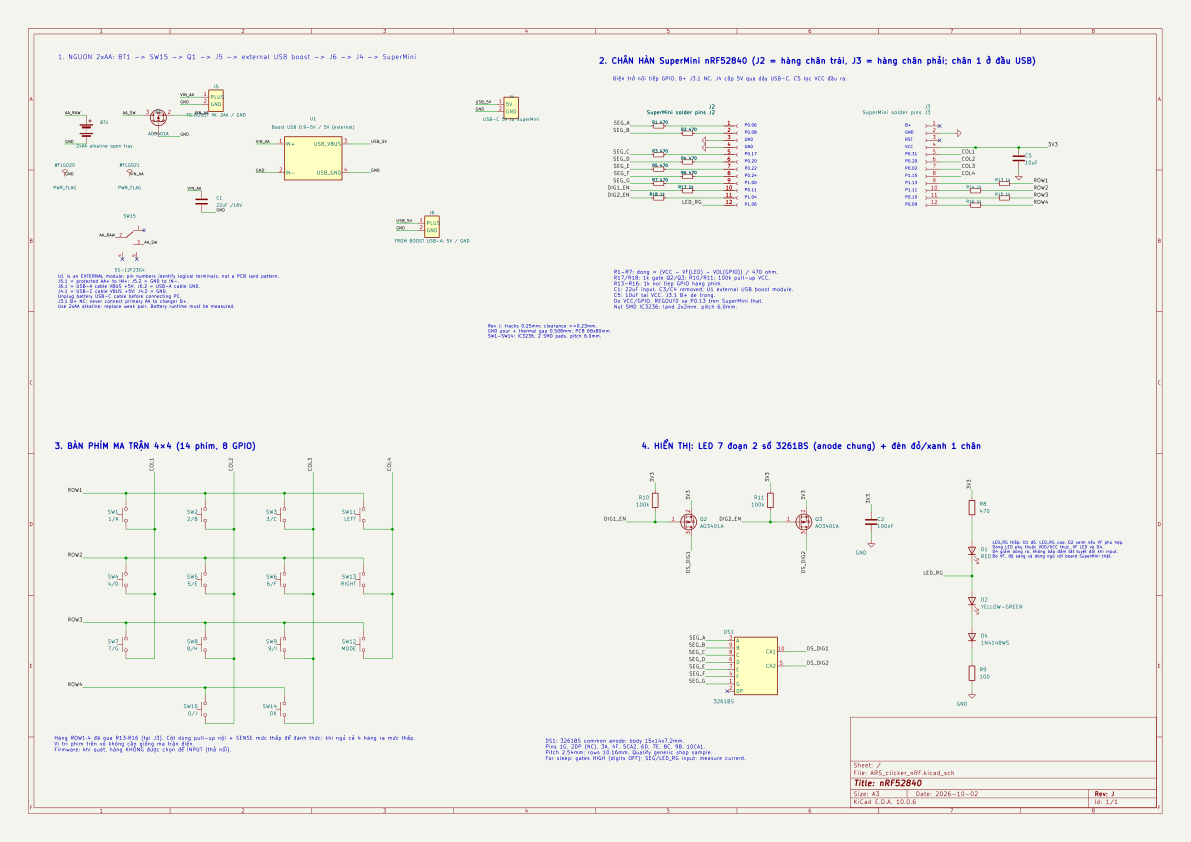
hardware/kicad/previews/Schematic.png
