Rubydangoday/Project_IOT_clicker/hardware/kicad/sources/SW_IC3236_drawing.jpg

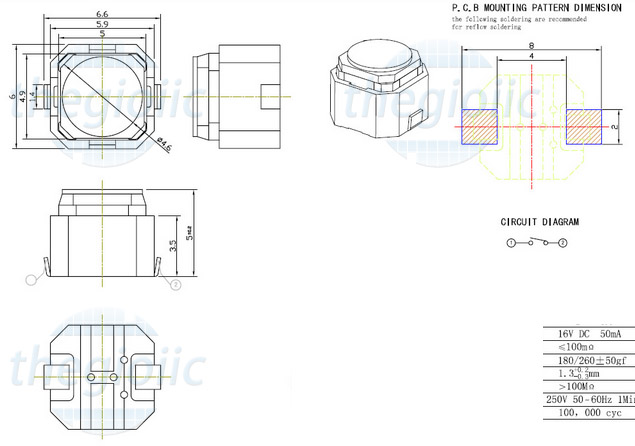
hardware/kicad/sources/SW_IC3236_drawing.jpg
