Rubydangoday/Project_IOT_clicker/hardware/kicad/sources/SW_SS12F23G4_shop_photo.jpg

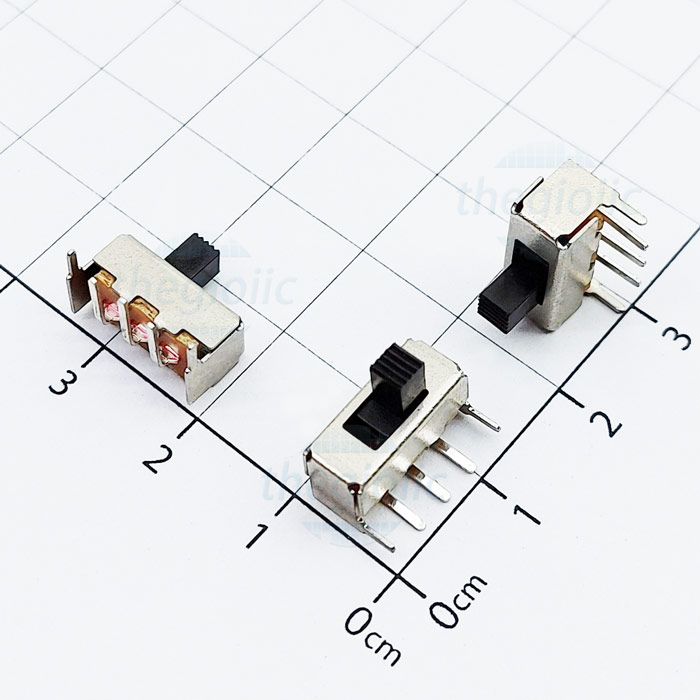
hardware/kicad/sources/SW_SS12F23G4_shop_photo.jpg
