Rubydangoday/Project_IOT_clicker/samples/de-thi-test/Bai_giang_ROS/de_ROS.docx

ĐỀ KIỂM TRA: ROBOT OPERATING SYSTEM

Theo bài giảng: bai-giang/Bai_giang_ROS · 20 câu · 30 giây/câu

Chủ đề: 2. ROS basics

Câu 1: Đơn vị tổ chức mã nguồn cơ bản ("basic cell") của ROS là:

A. Topic

B. Package

C. Launch file

D. Node

Đáp án: B

Giải thích: Package là đơn vị cơ bản; một package có thể chứa nhiều node.

Câu 2: Trong workspace ROS 2, thư mục nào chứa mã nguồn các package?

A. build

B. install

C. src

D. log

Đáp án: C

Giải thích: src: source space; build/install/log do colcon tạo.

Câu 3: Lệnh build workspace ROS 2 là:

A. ros2 build

B. colcon build

C. cmake --build

D. catkin_make

Đáp án: B

Giải thích: ROS 2 dùng colcon build (catkin_make là ROS 1).

Chủ đề: 2. Linux depth

Câu 4: Lệnh Linux nào in ra thư mục làm việc hiện tại?

A. ls

B. mkdir

C. pwd

D. cd

Đáp án: C

Giải thích: pwd – Print Working Directory.

Chủ đề: 2. ROS basics

Câu 5: Lệnh chạy một node trong ROS 2:

A. ros2 node <executable>

B. ros2 run <package> <executable>

C. rosrun <node>

D. ros2 start <node>

Đáp án: B

Giải thích: Ví dụ: ros2 run camera_opencv camera_publisher.

Câu 6: Thư viện client C++ của ROS 2 là:

A. roscpp

B. rclcpp

C. rclpy

D. tf2

Đáp án: B

Giải thích: rclcpp cho C++, rclpy cho Python.

Câu 7: File nào khai báo tên, phụ thuộc (dependencies) của một package ROS 2?

A. package.xml

B. CMakeCache.txt

C. setup.cfg

D. urdf.xml

Đáp án: A

Giải thích: package.xml cho ROS biết package là gì và phụ thuộc vào đâu.

Chủ đề: 3. Define your robot

Câu 8: URDF là định dạng mô tả robot dựa trên:

A. XML

B. YAML

C. CSV

D. JSON

Đáp án: A

Giải thích: Unified Robot Description Format là định dạng XML.

Câu 9: Hai phần tử chính của một mô hình URDF là:

A. link và joint

B. service và action

C. node và topic

D. world và plugin

Đáp án: A

Giải thích: Link: thành phần vật lý; joint: chuyển động tương đối giữa các link.

Câu 10: Thẻ nào trong một link dùng cho tính toán va chạm vật lý?

A. visual

B. inertial

C. collision

D. origin

Đáp án: C

Giải thích: collision dùng cho physics; visual chỉ để hiển thị.

Câu 11: Xacro được dùng để:

A. Điều khiển động cơ

B. Viết URDF gọn hơn bằng macro, chia nhiều file

C. Biên dịch package

D. Mô phỏng cảm biến

Đáp án: B

Giải thích: URDF dài và lặp; xacro cho phép macro, biến, chia file.

Câu 12: Gazebo mô tả model và world bằng định dạng nào?

A. STL

B. URDF

C. SDF

D. YAML

Đáp án: C

Giải thích: Simulation Description Format (SDF).

Chủ đề: 4. ROS Control

Câu 13: Thành phần nào của ros2_control là "phiên dịch" giữa thế giới ROS và phần cứng?

A. Resource Manager

B. Controller Manager

C. Broadcaster

D. Hardware Interface

Đáp án: D

Giải thích: Hardware interface là plugin C++ đọc/ghi phần cứng (read/write).

Câu 14: Thành phần được gọi là "trái tim" của ros2_control, quản lý vòng lặp thời gian thực:

A. URDF

B. Topic

C. Controller Manager

D. Hardware Interface

Đáp án: C

Giải thích: Controller manager quản lý thời gian vòng lặp và nạp/chạy controller.

Câu 15: Controller nào dùng cho robot di chuyển vi sai (differential drive)?

A. joint_state_broadcaster

B. joint_trajectory_controller

C. gripper_controller

D. diff_drive_controller

Đáp án: D

Giải thích: diff_drive_controller nhận cmd_vel, tính vận tốc hai bánh.

Chủ đề: 5. ROS Navigation

Câu 16: Thuật toán định vị robot trên bản đồ trong ROS (dùng particle filter, laser scan) là:

A. A*

B. GMapping

C. AMCL

D. EKF SLAM

Đáp án: C

Giải thích: Adaptive Monte Carlo Localization.

Câu 17: Trong ROS 2 lifecycle node, trạng thái nào là node đang làm việc thực sự?

A. Finalized

B. Unconfigured

C. Inactive

D. Active

Đáp án: D

Giải thích: Unconfigured → Inactive (sẵn sàng) → Active (đang chạy) → Finalized.

Chủ đề: 6. Behaviour Tree

Câu 18: Một node của Behavior Tree trả về những trạng thái nào?

A. Success / Failure / Running

B. True / False

C. Start / Stop

D. Idle / Busy / Error / Done

Đáp án: A

Giải thích: Control node và leaf node đều trả Success, Failure hoặc Running.

Câu 19: Node nào có đúng MỘT con và thay đổi kết quả của con (ví dụ Inverter)?

A. Sequence

B. Fallback

C. Action

D. Decorator

Đáp án: D

Giải thích: Decorator node: một con; Inverter đảo Success ↔ Failure.

Câu 20: So với máy trạng thái hữu hạn (FSM), Behavior Tree có ưu điểm chính là tính mô-đun, dễ mở rộng khi tác vụ phức tạp.

A. Đúng

B. Sai

Đáp án: A

Giải thích: FSM thiếu tính mô-đun, kém hiệu quả khi số tác vụ tăng.
