Rubydangoday/Project_IOT_clicker/samples/de-thi-test/Bai_giang_thiet_ke_robot/de_ROBOT.docx

ĐỀ KIỂM TRA: THIẾT KẾ ROBOT

Theo bài giảng: bai-giang/Bai_giang_thiet_ke_robot · 20 câu · 30 giây/câu

Chủ đề: 2. Tổng quan về TK Robot

Câu 1: Theo bài giảng, thiết kế robot là một quá trình:

A. Tuyến tính, làm một lần

B. Lặp lại và có thoả hiệp

C. Chỉ gồm phần cơ khí

D. Không cần thông số mục tiêu

Đáp án: B

Giải thích: Thiết kế là quá trình lặp lại, là sự thoả hiệp.

Câu 2: Bước 2 của quy trình thiết kế có mục tiêu gì?

A. Bảo trì sau bán hàng

B. Chuyển nhu cầu khách hàng thành thông số kỹ thuật cụ thể

C. Chế tạo mẫu thử

D. Chọn nhà cung cấp

Đáp án: B

Giải thích: Bước 2: Xác định thông số kỹ thuật.

Câu 3: Bước "Hỗ trợ sản phẩm" (bước 5) tập trung vào:

A. Duy trì vận hành và quản lý vòng đời robot sau khi ra mắt

B. Động não phương án

C. Tính bậc tự do

D. Lập kế hoạch dự án

Đáp án: A

Giải thích: Bước 5: hỗ trợ sản phẩm, vòng đời.

Câu 4: Công cụ chính của phương pháp Triển khai Chức năng Chất lượng (QFD) là:

A. Bảng phân phối nguồn

B. Ngôi nhà chất lượng (House of Quality)

C. Biểu đồ Gantt

D. Sơ đồ động học

Đáp án: B

Giải thích: QFD chuyển mong muốn mơ hồ của người dùng thành đặc tính kỹ thuật qua House of Quality.

Câu 5: Phương pháp phân tích dựa trên nhiệm vụ (MBA) xác định thông số mục tiêu từ:

A. Màu sắc sản phẩm

B. Số lượng linh kiện

C. Giá thành đối thủ

D. Kịch bản vận hành cuối cùng của robot

Đáp án: D

Giải thích: MBA dựa trên kịch bản vận hành; ví dụ robot Sojourner của NASA.

Câu 6: Robot nào được dùng làm ví dụ cho phương pháp MBA trong bài giảng?

A. Unitree Go 2

B. NASA Sojourner

C. Boston Dynamics Spot

D. ASIMO

Đáp án: B

Giải thích: NASA’s first Mars rover – Sojourner.

Câu 7: Phương pháp so sánh (benchmarking) dùng để đo chênh lệch giữa robot của mình và đối thủ.

A. Đúng

B. Sai

Đáp án: A

Giải thích: Từ đó đề xuất thông số mục tiêu cạnh tranh.

Chủ đề: 3. Mechanical Design

Câu 8: Ký hiệu trong sơ đồ động học phải theo tiêu chuẩn nào?

A. IP67

B. USB

C. ISO

D. IEEE

Đáp án: C

Giải thích: Các ký hiệu phải theo tiêu chuẩn ISO.

Câu 9: Cơ cấu phẳng chuỗi hở gồm giá cố định và 3 khâu động nối bằng 3 khớp xoay có bao nhiêu bậc tự do?

A. 6

B. 1

C. 2

D. 3

Đáp án: D

Giải thích: Grübler phẳng: M = 3(n − 1) − 2·j1 = 3·3 − 2·3 = 3.

Câu 10: Trên chân robot chó, khâu L1 (hip abduction–adduction) giúp:

A. Đo góc nghiêng

B. Tăng tốc độ chạy

C. Giảm khối lượng pin

D. Chân không va chạm với thân robot

Đáp án: D

Giải thích: L1 giúp chân không va chạm với thân robot.

Câu 11: Diện tích ellipsoid vận tốc của bàn chân càng lớn thì:

A. Động cơ càng nóng

B. Cơ cấu càng kém linh hoạt

C. Cơ cấu càng linh hoạt

D. Không ảnh hưởng

Đáp án: C

Giải thích: Ellipsoid đại diện mức độ linh hoạt của cơ cấu: càng lớn càng tốt.

Câu 12: Trình tự thiết kế chi tiết các khớp chân robot chó là:

A. Đùi → hông → gối

B. Tuỳ ý

C. Hông → đùi → gối

D. Gối → đùi → hông

Đáp án: D

Giải thích: Từ khớp đơn giản tới phức tạp: gối → đùi → hông.

Câu 13: Tiêu chí nào thuộc 3 tiêu chí chọn động cơ trong bài giảng?

A. Màu vỏ động cơ

B. Thương hiệu

C. Kích thước dây

D. Quán tính của tải (load inertia)

Đáp án: D

Giải thích: 3 tiêu chí: mô men xoắn, quán tính tải, tốc độ.

Câu 14: Khớp xoay chạy tốc độ thấp (< 200 rpm) nhưng chịu tải lớn nên chọn:

A. Bạc lót

B. Khớp cầu nhựa

C. Không cần ổ đỡ

D. Ổ bi

Đáp án: A

Giải thích: Ổ bi: tốc độ cao (200–100k rpm); bạc lót: < 200 rpm, chịu tải cao hơn.

Chủ đề: 4. Electronics Design

Câu 15: Điện áp hệ thống điển hình của AGV và robot chó theo bảng thông số mục tiêu:

A. 3,3 – 5 V

B. 24 – 48 V

C. 12 V

D. 220 V xoay chiều

Đáp án: B

Giải thích: AGV, robot chó: 24–48 V; UAV: pin 4S–14S.

Câu 16: Cảm biến nào thuộc nhóm cảm biến trạng thái (đo trạng thái của chính robot)?

A. Camera

B. Lidar

C. Cảm biến siêu âm

D. Encoder bánh xe

Đáp án: D

Giải thích: Cảm biến trạng thái: pin, encoder, IMU; cảm biến môi trường: camera, lidar.

Câu 17: Mạch buck converter dùng để:

A. Đảo chiều động cơ

B. Hạ áp cho từng nhánh nguồn

C. Tăng áp

D. Sạc pin không dây

Đáp án: B

Giải thích: Bước 2 tính toán nguồn: chọn mạch hạ áp (buck) cho từng nhánh.

Câu 18: Robot tiêu thụ dòng trung bình 5 A, cần chạy 4 giờ. Dung lượng pin tối thiểu (bỏ qua hao hụt):

A. 1,25 Ah

B. 20 Ah

C. 9 Ah

D. 40 Ah

Đáp án: B

Giải thích: Dung lượng = dòng trung bình × thời gian = 5 A × 4 h = 20 Ah.

Câu 19: Băng ISM 2,4 GHz là viết tắt của:

A. International Standard Modulation

B. Integrated System Module

C. Internet, Sensor and Mobile

D. Industry, Science and Medical

Đáp án: D

Giải thích: ISM: Industry, Science and Medical, 2,4–2,4835 GHz.

Câu 20: Quan hệ giữa tần số f và bước sóng λ của sóng RF (c là tốc độ ánh sáng):

A. λ = f / c

B. λ = c / f

C. λ = c · f

D. λ = 1 / (c · f)

E. λ = c + f

Đáp án: B

Giải thích: λ = c / f: tần số càng cao bước sóng càng ngắn.
