Rubydangoday/Project_IOT_clicker/samples/de-thi-test/Bai_giang_RTOS/de_RTOS.docx

ĐỀ KIỂM TRA: HỆ THỐNG THỜI GIAN THỰC

Theo bài giảng: bai-giang/Bai_giang_RTOS · 20 câu · 30 giây/câu

Chủ đề: 1. Introduction

Câu 1: Một hệ thống thời gian thực được coi là đúng khi:

A. Chạy càng nhanh càng tốt

B. Kết quả đúng logic và đúng thời điểm (đáp ứng deadline)

C. Không có ngắt

D. Dùng hệ điều hành Linux

Đáp án: B

Giải thích: Correctness phụ thuộc cả kết quả logic lẫn thời điểm tạo ra kết quả.

Câu 2: Real-time computing tương đương với tính toán:

A. Dự đoán được (predictable)

B. Tiết kiệm năng lượng

C. Nhanh nhất có thể

D. Song song

Đáp án: A

Giải thích: Myth: real-time = fast. Truth: real-time = predictable.

Chủ đề: 2. RT system model

Câu 3: Trong hệ thời gian thực cứng (hard real-time), lỡ một deadline thì:

A. Chỉ giảm chất lượng dịch vụ

B. Chấp nhận được nếu hiếm

C. Hệ thống bị coi là sai

D. Tác vụ được chạy lại sau

Đáp án: C

Giải thích: Hard deadline: mọi deadline phải được đáp ứng.

Chủ đề: 1. Introduction

Câu 4: Task là đơn vị công việc nhỏ nhất có thể lập lịch.

A. Đúng

B. Sai

Đáp án: A

Giải thích: Task is the smallest schedulable unit of work.

Chủ đề: 2. RT system model

Câu 5: Loại task nào có các job lặp lại đều đặn theo chu kỳ?

A. Sporadic

B. Aperiodic

C. Periodic

D. Background

Đáp án: C

Giải thích: Periodic task: job được thực thi lặp lại theo chu kỳ cố định.

Câu 6: Task đến không đều nhưng có deadline cứng gọi là:

A. Sporadic task

B. Aperiodic task

C. Periodic task

D. Idle task

Đáp án: A

Giải thích: Sporadic: đến bất thường, deadline cứng; aperiodic: deadline mềm hoặc không có.

Câu 7: Ký hiệu C_i trong mô hình task là:

A. Thời gian thực thi xấu nhất (WCET)

B. Chu kỳ

C. Deadline tương đối

D. Thời điểm phát hành

Đáp án: A

Giải thích: Execution time C_i: thường lấy WCET.

Chủ đề: 3. Clock-driven scheduling

Câu 8: Các task có chu kỳ 4, 5, 20, 20. Hyperperiod H bằng:

A. 4

B. 400

C. 20

D. 10

Đáp án: C

Giải thích: H = bội chung nhỏ nhất (LCM) các chu kỳ = 20.

Câu 9: Lập lịch theo đồng hồ (clock-driven) phù hợp nhất với hệ thống:

A. Xác định trước, tham số mọi task periodic đã biết

B. Đa lõi không đồng bộ

C. Tham số task thay đổi liên tục

D. Nhiều task aperiodic

Đáp án: A

Giải thích: Bảng lịch tính offline cho hệ deterministic.

Câu 10: Ràng buộc kích thước khung (frame) f trong clock-driven scheduling:

A. f tuỳ ý

B. f không nhỏ hơn thời gian thực thi lớn nhất max(C_i)

C. f nhỏ hơn mọi C_i

D. f bằng hyperperiod

Đáp án: B

Giải thích: Mỗi job phải chạy xong trong một khung: f ≥ max(C_i); f còn phải chia hết H.

Chủ đề: 4. Priority-driven scheduling

Câu 11: Rate Monotonic Scheduling (RMS) gán độ ưu tiên theo:

A. Deadline tuyệt đối

B. Chu kỳ: chu kỳ ngắn hơn → ưu tiên cao hơn

C. Thứ tự đến

D. Thời gian thực thi dài hơn → ưu tiên cao hơn

Đáp án: B

Giải thích: RMS: the shorter the period, the higher the priority.

Chủ đề: 4. Priority-driven scheduling (cont)

Câu 12: Deadline Monotonic Scheduling (DMS) gán ưu tiên cao hơn cho task có:

A. WCET lớn hơn

B. Slack lớn hơn

C. Chu kỳ dài hơn

D. Deadline tương đối ngắn hơn

Đáp án: D

Giải thích: DMS: relative deadline ngắn hơn → ưu tiên cao hơn.

Chủ đề: 4. Priority-driven scheduling

Câu 13: Khi số task n rất lớn, giới hạn hiệu suất Liu & Layland của RMS xấp xỉ:

A. 50%

B. 69,3%

C. 82,8%

D. 100%

Đáp án: B

Giải thích: U ≤ n(2^(1/n) − 1) → ln 2 ≈ 0,693.

Câu 14: Ba task T1(4,1), T2(5,2), T3(20,5) (chu kỳ, WCET). Tổng hiệu suất U là:

A. 0,75

B. 0,90

C. 0,85

D. 1,10

Đáp án: B

Giải thích: U = 1/4 + 2/5 + 5/20 = 0,25 + 0,40 + 0,25 = 0,90 (vượt giới hạn L&L 0,78 nhưng RTA vẫn lập lịch được).

Chủ đề: 4. Priority-driven scheduling (cont)

Câu 15: Earliest Deadline First (EDF) ưu tiên task có:

A. WCET nhỏ nhất

B. Deadline tuyệt đối sớm nhất

C. Slack nhỏ nhất

D. Chu kỳ ngắn nhất

Đáp án: B

Giải thích: EDF là thuật toán ưu tiên động phổ biến nhất.

Câu 16: Trên một bộ xử lý, task độc lập, có chiếm quyền, D_i = p_i: EDF lập lịch được khi và chỉ khi:

A. U ≤ 1

B. U ≤ 0,828

C. U ≤ 0,693

D. U ≤ 2

Đáp án: A

Giải thích: EDF tối ưu: schedulable iff U ≤ 1.

Câu 17: Thuật toán Least Slack Time First (LST) ưu tiên task có:

A. Slack (laxity) nhỏ nhất

B. Deadline muộn nhất

C. Chu kỳ dài nhất

D. Slack lớn nhất

Đáp án: A

Giải thích: LST cùng điều kiện như EDF, ưu tiên laxity nhỏ nhất.

Chủ đề: 4. Priority-driven scheduling

Câu 18: Khi chiếm quyền (preemption), hệ điều hành phải làm gì với task đang chạy?

A. Xoá task

B. Khởi động lại CPU

C. Lưu ngữ cảnh (context) rồi chuyển sang task ưu tiên cao

D. Chờ task chạy xong

Đáp án: C

Giải thích: Context switch: lưu thanh ghi/ngăn xếp của task bị chiếm quyền.

Chủ đề: 5. Aperiodic and sporadic tasks

Câu 19: Background scheduling chạy job aperiodic khi nào?

A. Ngay khi job đến

B. Chỉ khi không còn job periodic/sporadic nào sẵn sàng

C. Theo chu kỳ cố định

D. Trước mọi job periodic

Đáp án: B

Giải thích: Đơn giản, nhưng thời gian đáp ứng aperiodic có thể rất lớn.

Câu 20: Server nào GIỮ LẠI ngân sách (budget) khi hàng đợi aperiodic đang rỗng?

A. Polling server

B. Interrupt server

C. Background server

D. Deferrable server

E. Idle server

Đáp án: D

Giải thích: Polling server mất budget nếu hàng đợi rỗng; deferrable server hoãn và giữ budget.
