Rubydangoday/Project_IOT_clicker/samples/de-thi-test/Bai_giang_AI/de_AI.csv

STT | Noi dung | So lua chon | A | B | C | D | E | F | G | H | I | J | Dap an | Thoi gian | Chu de | Giai thich
1 | Loại AI agent nào chỉ hành động dựa trên nhận thức hiện tại, bỏ qua lịch sử, theo luật điều kiện–hành động? | 4 | Utility-based agent | Simple reflex agent | Goal-based agent | Model-based reflex agent |  |  |  |  |  |  | B | 30 | 1. Introduction | Simple reflex agent chỉ dùng percept hiện tại và luật condition–action, ví dụ robot phân loại thư.
2 | Robot hút bụi dùng bản đồ phòng và nhớ vùng đã dọn là ví dụ của loại agent nào? | 4 | Simple reflex agent | Learning agent | Model-based reflex agent | Utility-based agent |  |  |  |  |  |  | C | 30 | 1. Introduction | Model-based reflex agent dùng bộ nhớ và lịch sử nhận thức để xây mô hình môi trường (quan sát được một phần).
3 | Utility-based agent được mô tả là: | 4 | Goal-based agent cộng tối ưu hàm tiện ích | Learning agent không có mục tiêu | Simple reflex agent có thêm bộ nhớ | Agent chỉ hoạt động trong môi trường quan sát đầy đủ |  |  |  |  |  |  | A | 30 | 1. Introduction | Utility-based agent = Goal-based agent + tối ưu utility (mức độ "tốt" của trạng thái).
4 | Thuật ngữ "Artificial Intelligence" ra đời vào năm nào? | 4 | 2012 | 1956 | 1997 | 1943 |  |  |  |  |  |  | B | 30 | 1. Introduction | Năm 1956 (hội thảo Dartmouth).
5 | Deep Blue đánh bại kỳ thủ Garry Kasparov năm 1997. | 2 | Đúng | Sai |  |  |  |  |  |  |  |  | A | 30 | 1. Introduction | Đúng — mốc lịch sử AI trong slide giới thiệu.
6 | Thành phần nào của bài toán tìm kiếm kiểm tra trạng thái hiện tại có phải trạng thái đích? | 4 | Initial state | Goal test | Transition function | Path cost |  |  |  |  |  |  | B | 30 | 2. Search Algorithms | Goal test: x ∈ S → GOAL?(x) = T hoặc F.
7 | Bài toán 8-puzzle có bao nhiêu trạng thái (9!)? | 4 | 16! | 40 320 | 362 880 | 1,04 × 10^13 |  |  |  |  |  |  | C | 30 | 2. Search Algorithms | 8-puzzle có 9! = 362 880 trạng thái.
8 | Breadth-first search (BFS) luôn mở rộng nút nào trước? | 4 | Nút có chi phí nhỏ nhất | Nút sâu nhất | Nút có heuristic nhỏ nhất | Nút nông nhất |  |  |  |  |  |  | D | 30 | 2. Search Algorithms | BFS: expand a shallowest node first.
9 | Uniform cost search mở rộng nút nào trước? | 4 | Nút có chi phí đường đi tích luỹ nhỏ nhất | Nút nông nhất | Nút sâu nhất | Nút có h(n) nhỏ nhất |  |  |  |  |  |  | A | 30 | 2. Search Algorithms | UCS: expand a cheapest node first.
10 | A* chọn nút theo hàm đánh giá nào? | 4 | f(n) = h(n) | f(n) = g(n) + h(n) | f(n) = g(n) | f(n) = g(n) − h(n) |  |  |  |  |  |  | B | 30 | 2. Search Algorithms | A* kết hợp chi phí đã đi g(n) và heuristic h(n); greedy search chỉ dùng h(n).
11 | Trong heuristic search, danh sách CLOSED chứa: | 4 | Các nút chưa được mở rộng | Các nút có heuristic âm | Các nút đích | Các nút đã được mở rộng |  |  |  |  |  |  | D | 30 | 2. Search Algorithms | OPEN: nút chưa mở rộng; CLOSED: nút đã mở rộng.
12 | Công thức Bayes là: | 4 | P(A|B) = P(B|A) / P(A) | P(A|B) = P(A)·P(B) | P(A|B) = P(B|A)·P(A) / P(B) | P(A|B) = P(A) + P(B) |  |  |  |  |  |  | C | 30 | 3. Probabilistic Reasoning | Bayes cho phép tính một xác suất có điều kiện từ chiều ngược lại.
13 | Hai biến ngẫu nhiên X và Y độc lập khi: | 4 | P(X|Y) = P(Y|X) | P(X) = P(Y) | P(X, Y) = P(X)·P(Y) | P(X, Y) = P(X) + P(Y) |  |  |  |  |  |  | C | 30 | 3. Probabilistic Reasoning | Độc lập: phân phối kết hợp bằng tích các phân phối biên.
14 | Bayesian network biểu diễn phân phối kết hợp bằng: | 4 | Tích các phân phối có điều kiện của mỗi biến theo các biến cha | Một bảng lớn duy nhất | Tổng các xác suất biên | Một mạng nơ-ron |  |  |  |  |  |  | A | 30 | 3. Probabilistic Reasoning | Bayes net mã hoá phân phối kết hợp thành tích các phân phối có điều kiện cục bộ.
15 | Decision network chọn hành động như thế nào? | 4 | Hành động có chi phí nhỏ nhất | Hành động có xác suất thành công cao nhất | Ngẫu nhiên | Hành động tối đa kỳ vọng tiện ích (expected utility) với bằng chứng đã có |  |  |  |  |  |  | D | 30 | 3. Probabilistic Reasoning | Decision network gồm action node, chance node, utility node; chọn hành động maximize expected utility.
16 | Naïve Bayes là thuật toán học có giám sát dùng cho bài toán phân loại (ví dụ lọc thư rác). | 2 | Đúng | Sai |  |  |  |  |  |  |  |  | A | 30 | 3. Probabilistic Reasoning | Đúng — slide nêu ví dụ spam email và nhận dạng chữ số.
17 | Adaboost thuộc họ "boosting", có nhiệm vụ: | 4 | Tăng cường dữ liệu ảnh | Giảm số chiều dữ liệu | Phân cụm dữ liệu không nhãn | Kết hợp nhiều weak learner thành strong learner |  |  |  |  |  |  | D | 30 | 4. Learning Algorithm | Boosting: biến các bộ học yếu thành bộ học mạnh bằng trọng số.
18 | Định lý hội tụ perceptron đảm bảo trọng số ngừng thay đổi sau hữu hạn bước khi nào? | 4 | Tốc độ học bằng 0 | Hai lớp tách được tuyến tính | Dữ liệu có nhiễu | Có nhiều hơn hai lớp |  |  |  |  |  |  | B | 30 | 4. Learning Algorithm | Perceptron Convergence Theorem: nếu C1, C2 linearly separable.
19 | Hàm kích hoạt nào là mô hình McCulloch-Pitts (1943)? | 5 | ReLU | Gaussian | Threshold (hàm ngưỡng) | Hyperbolic tangent | Logistic (sigmoid) |  |  |  |  |  | C | 30 | 4. Learning Algorithm | McCulloch-Pitts dùng hàm ngưỡng; sigmoid, tanh, Gaussian là các hàm squash khác.
20 | GAN huấn luyện hai mạng cạnh tranh nhau, đó là: | 4 | Teacher và Student | Encoder và Decoder | Generator và Discriminator | Actor và Critic |  |  |  |  |  |  | C | 30 | 9. Generative Adversarial Network | Generator sinh mẫu giống dữ liệu thật; Discriminator phân loại thật/giả.
