Rubydangoday/Project_IOT_clicker/tests/previews/parent.png

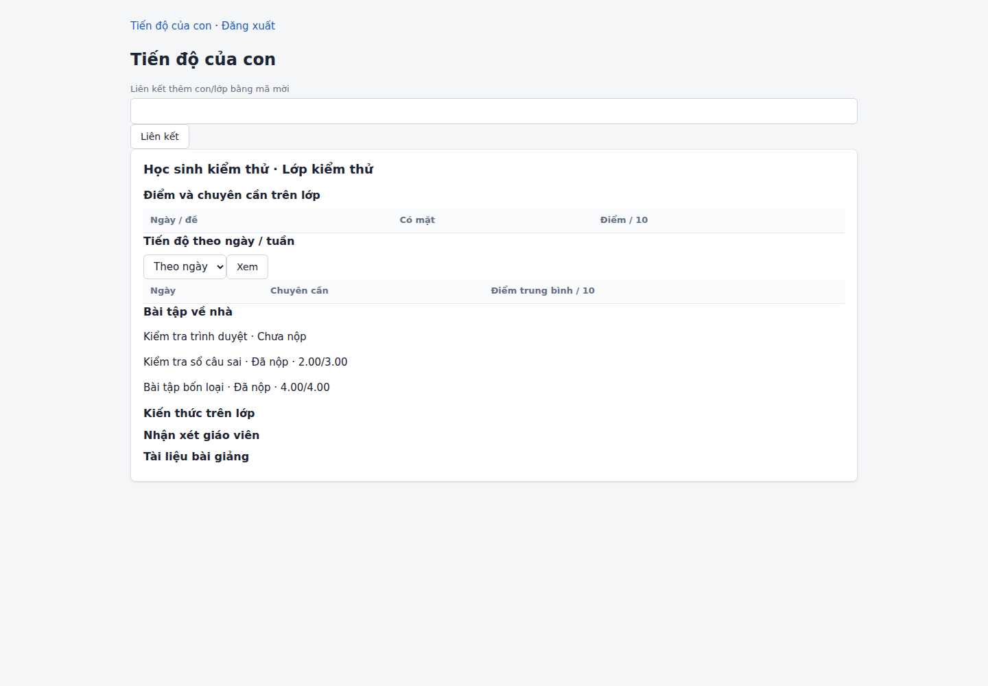
tests/previews/parent.png
