Rubydangoday/Project_IOT_clicker/tests/previews/student-mobile.png

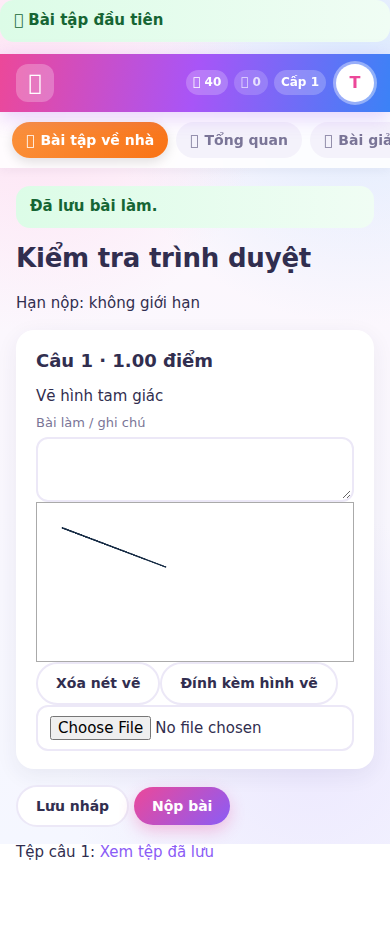
tests/previews/student-mobile.png
