Rubydangoday/Project_IOT_clicker/tests/previews/teacher.png

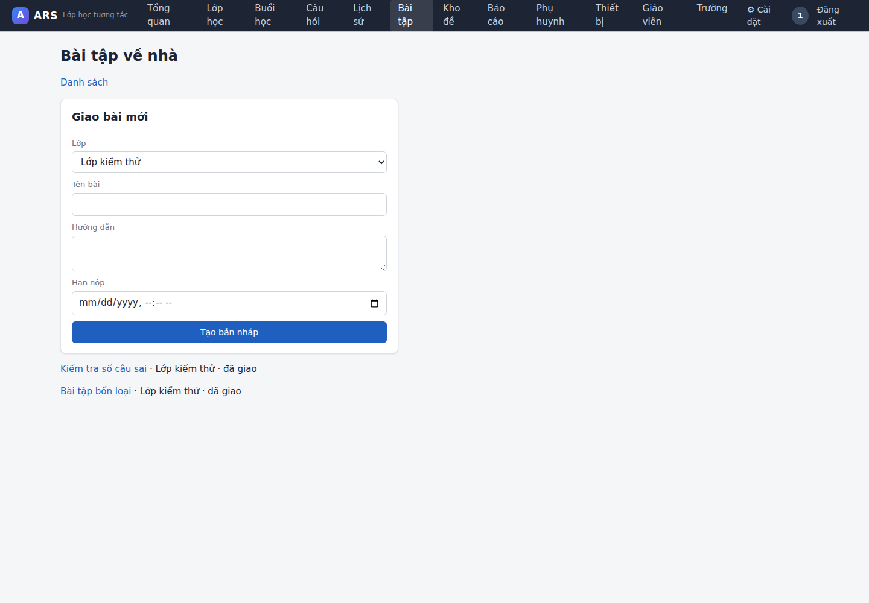
tests/previews/teacher.png
