Rubydangoday/Project_IOT_clicker/docs/phien-ban/CHANGES_V10.md

# Tệp thay đổi v10

Đối chiếu trực tiếp với ZIP đầu vào. Tính năng và giới hạn: UPGRADE_V10.md.

## Thêm

- `UPGRADE_V10.md`
- `db/migrate_005_lms.sql`
- `tests/README.md`
- `tests/RESULTS.md`
- `tests/core_test.php`
- `tests/extended_integration.py`
- `tests/http_smoke.py`
- `tests/ingest_integration.py`
- `tests/seed.php`
- `tests/ui_smoke.cjs`
- `web/analytics.php`
- `web/assets/capture.js`
- `web/assets/math.js`
- `web/family.php`
- `web/homework.php`
- `web/homework_grade.php`
- `web/lib/lms.php`
- `web/lib/variants.php`
- `web/library.php`
- `web/lms_file.php`
- `web/mapping.php`
- `web/media.php`
- `web/parent/home.php`
- `web/parent/index.php`
- `web/question_file.php`
- `web/schools.php`
- `web/set_docx.php`
- `web/set_export.php`
- `web/set_print.php`
- `web/student/homework.php`
- `web/variants.php`
- `web/assets/vendor/katex/` (KaTeX 0.16.22, MIT)
- `tests/previews/` (ảnh kiểm thử dữ liệu giả)

## Sửa

- `HUONG_DAN_CAI_DAT.md`
- `README.md`
- `deploy/install_ubuntu.sh`
- `ingest/ingest.py`
- `web/api/action.php`
- `web/api/state.php`
- `web/assets/projector.js`
- `web/assets/student.css`
- `web/assets/style.css`
- `web/compose.php`
- `web/devices.php`
- `web/file.php`
- `web/lib/bootstrap.php`
- `web/lib/qparse.php`
- `web/lib/student.php`
- `web/lib/tutor.php`
- `web/portal.php`
- `web/projector.php`
- `web/set.php`
- `web/sets.php`
- `web/student/api_tutor.php`
- `web/student/quiz.php`
- `web/student/start.php`
- `web/student/tutor.php`
- `web/student/wrong.php`
