Rubydangoday/Project_IOT_clicker/hardware/kicad/ARS_clicker_nRF.kicad_pcb

## KiCad design hardware/kicad/ARS_clicker_nRF.kicad_pcb (2026-10-15)

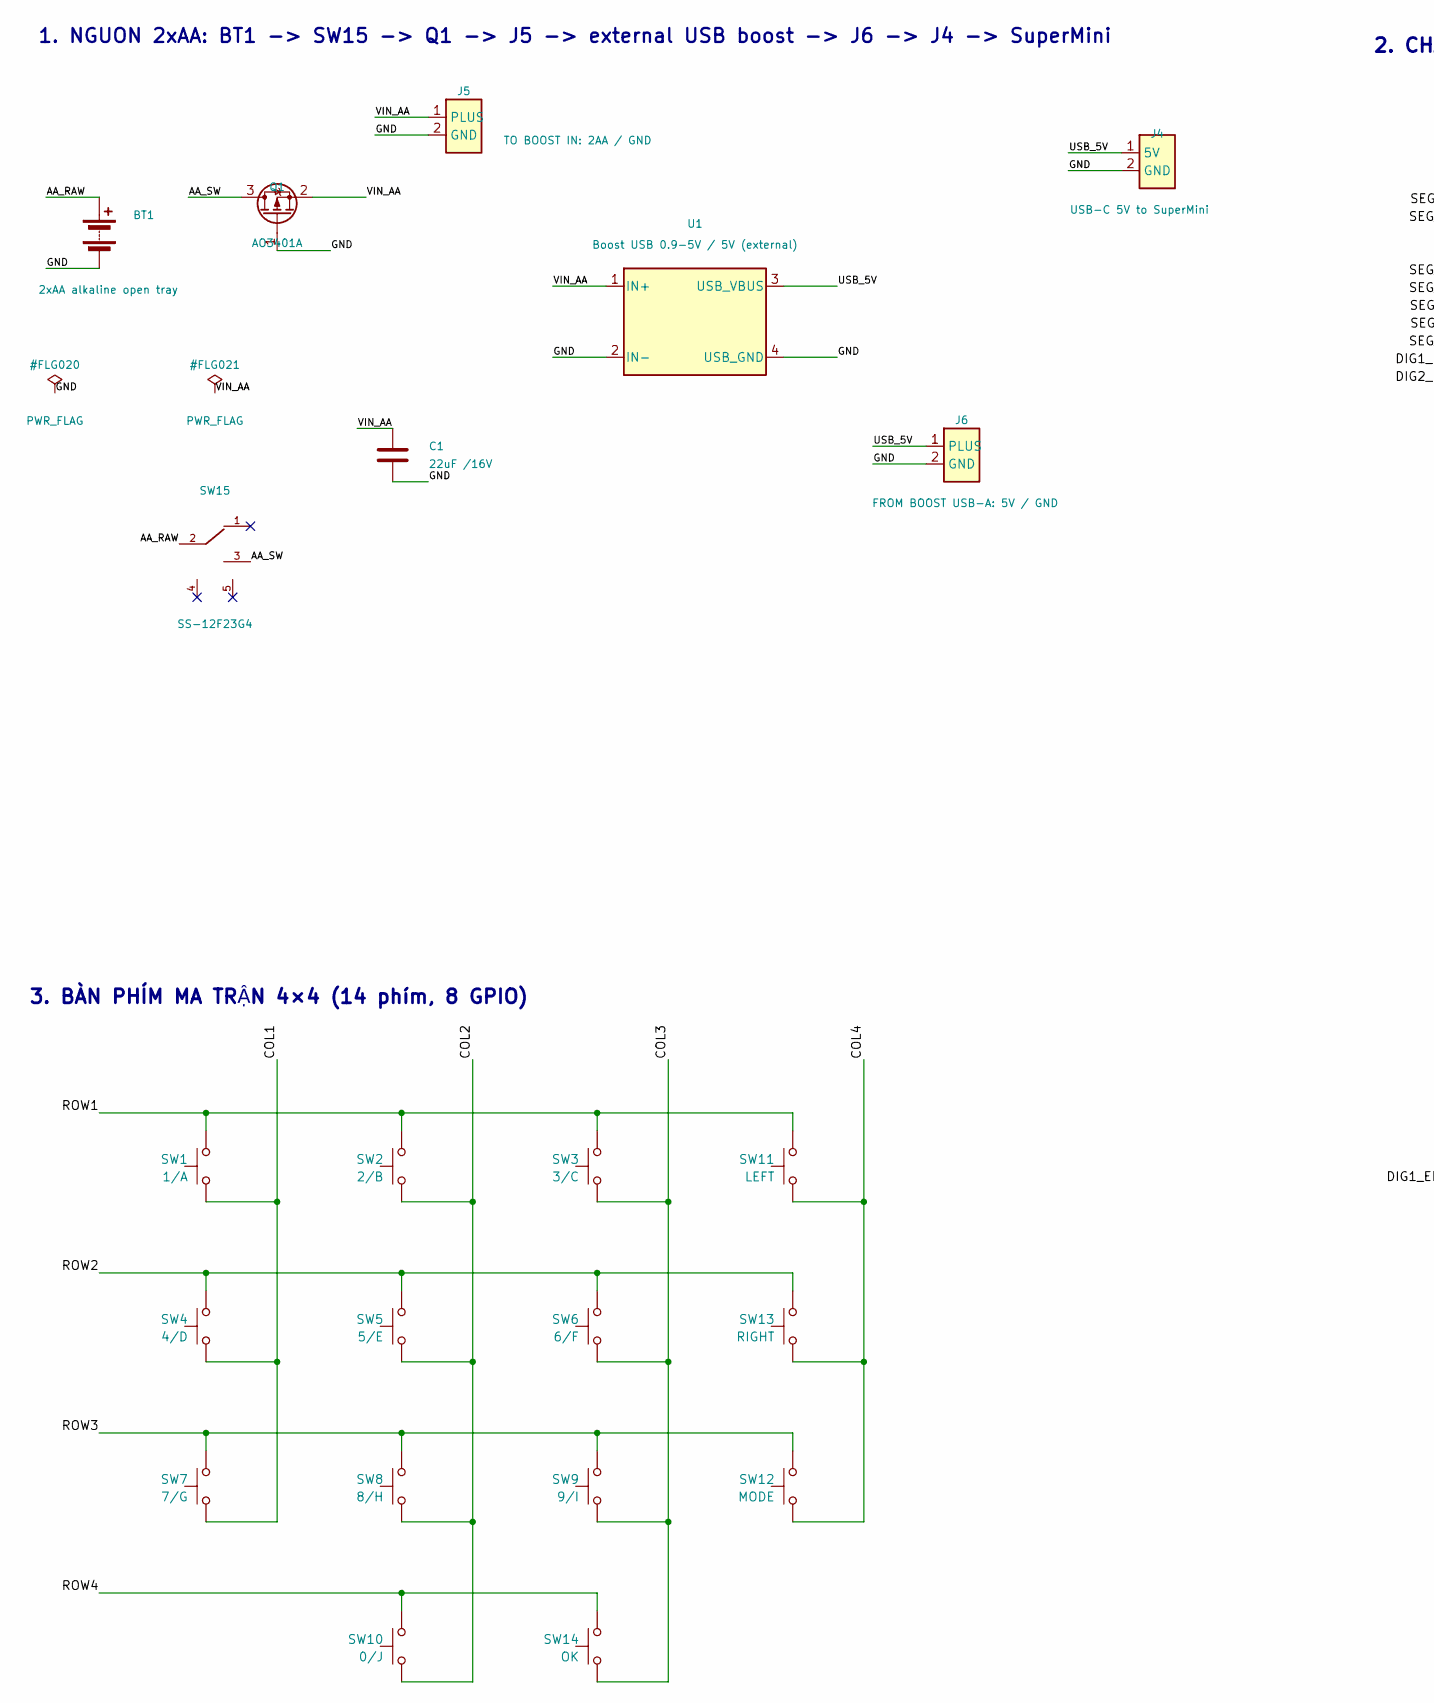
[picture p31: schematic ARS_clicker_nRF.kicad_sch, nRF52840, part in row 1, column 1]

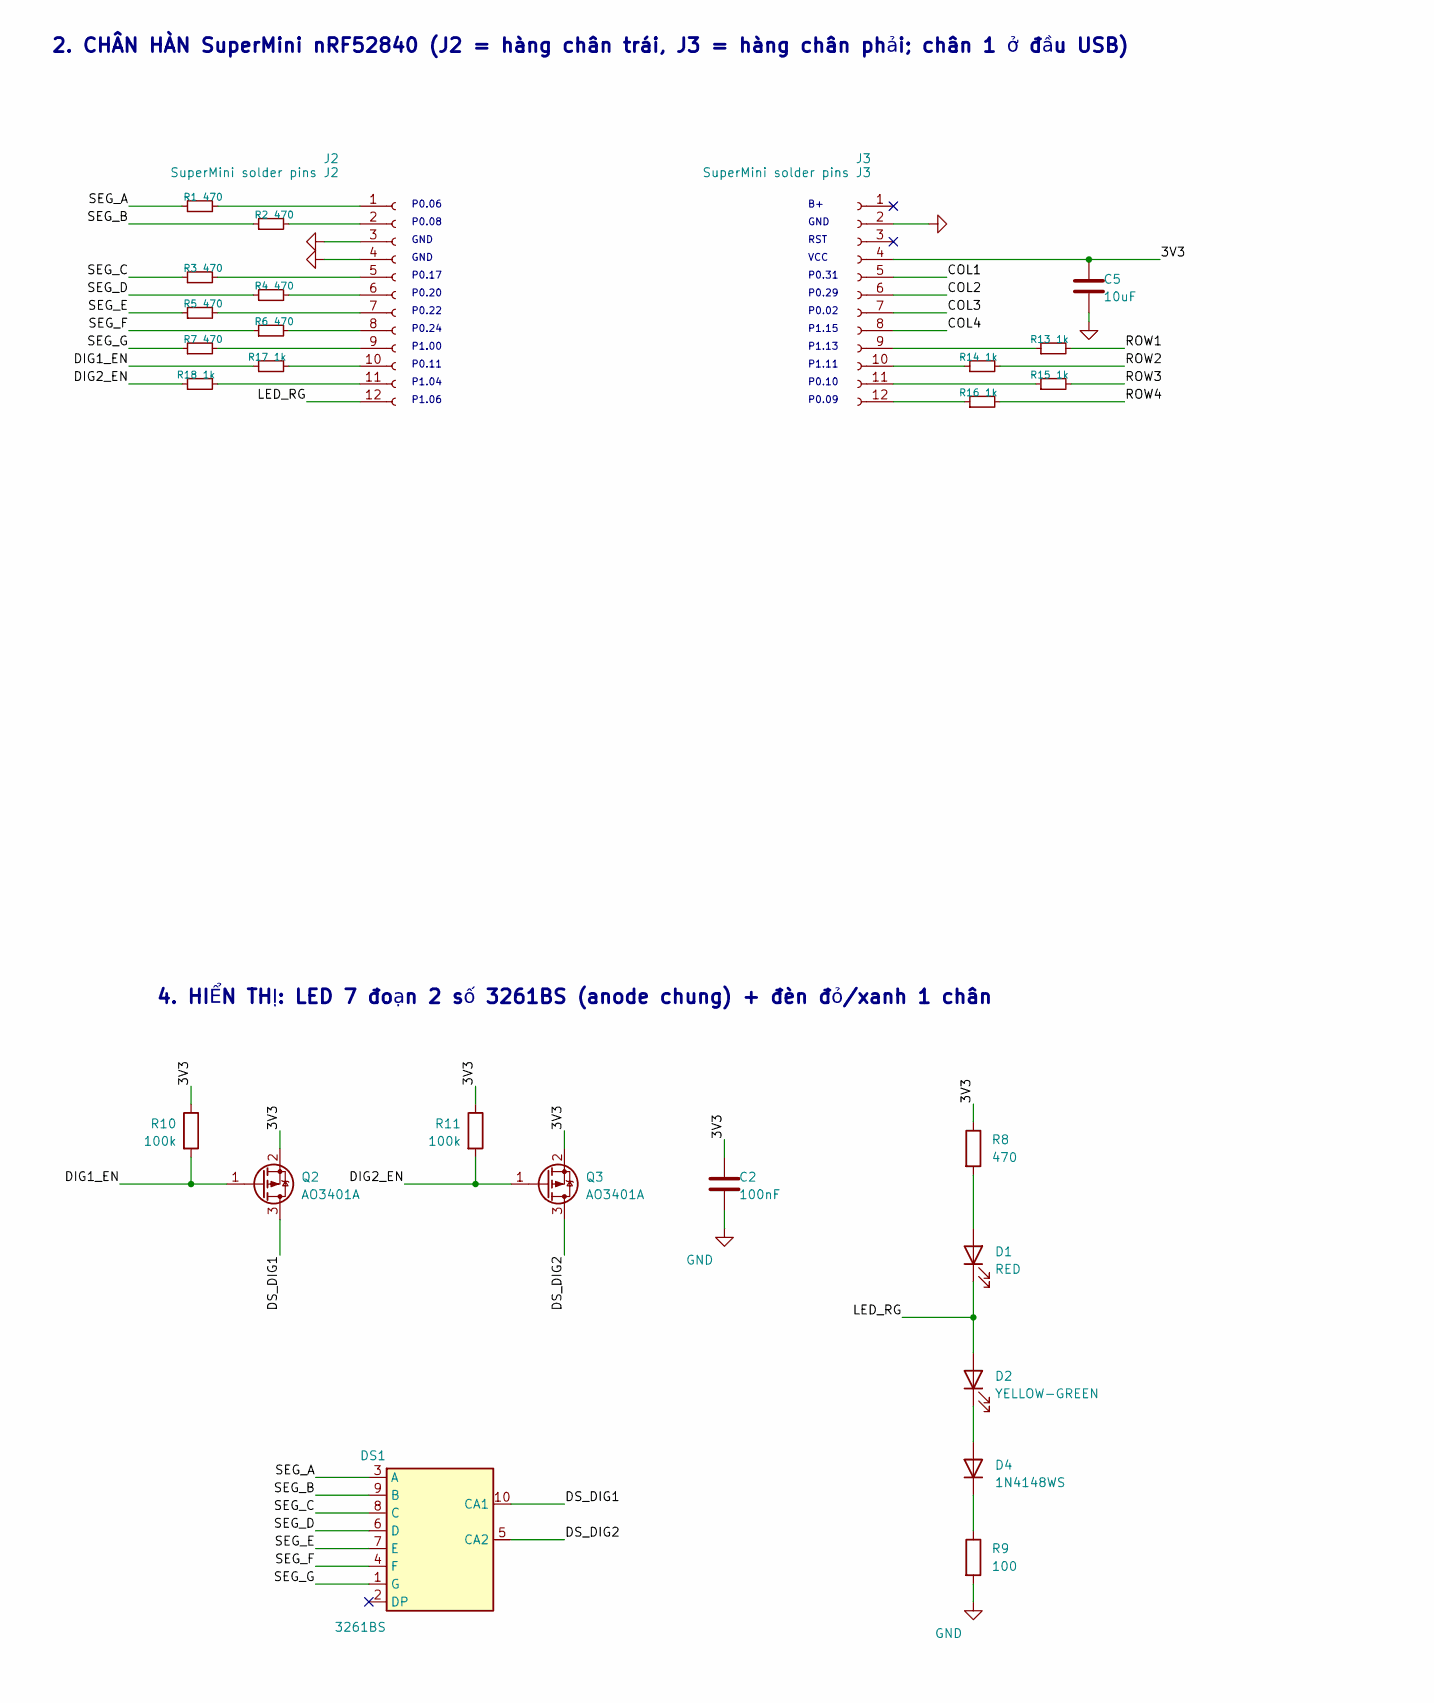
[picture p32: schematic ARS_clicker_nRF.kicad_sch, nRF52840, part in row 1, column 2]

Parts:
BT1: 2xAA alkaline open tray; SolderWire-0.5sqmm_1x02_P4.6mm_D0.9mm_OD2.1mm
C1: 22uF /16V; C_1206_3216Metric
C2: 100nF; C_0603_1608Metric
C5: 10uF; C_0603_1608Metric
D1: RED; LED_0603_1608Metric
D2: YELLOW-GREEN; LED_0603_1608Metric
D4: 1N4148WS; D_SOD-323
DS1: 3261BS
J2: SuperMini solder pins J2; ModulePins_1x12_P2.54mm_Low
J3: SuperMini solder pins J3; ModulePins_1x12_P2.54mm_Low
J4: USB-C 5V to SuperMini; SolderWire-0.5sqmm_1x02_P4.6mm_D0.9mm_OD2.1mm
J5: TO BOOST IN: 2AA / GND; SolderWire-0.5sqmm_1x02_P4.6mm_D0.9mm_OD2.1mm
J6: FROM BOOST USB-A: 5V / GND; SolderWire-0.5sqmm_1x02_P4.6mm_D0.9mm_OD2.1mm
Q1, Q2, Q3: AO3401A; SOT-23
R1, R2, R3, R4, R5, R6, R7, R8: 470; R_0603_1608Metric
R9: 100; R_0603_1608Metric
R10, R11: 100k; R_0603_1608Metric
R13, R14, R15, R16, R17, R18: 1k; R_0603_1608Metric
SW1: 1/A; SW_IC3236_2pin_SMD_P6mm
SW2: 2/B; SW_IC3236_2pin_SMD_P6mm
SW3: 3/C; SW_IC3236_2pin_SMD_P6mm
SW4: 4/D; SW_IC3236_2pin_SMD_P6mm
SW5: 5/E; SW_IC3236_2pin_SMD_P6mm
SW6: 6/F; SW_IC3236_2pin_SMD_P6mm
SW7: 7/G; SW_IC3236_2pin_SMD_P6mm
SW8: 8/H; SW_IC3236_2pin_SMD_P6mm
SW9: 9/I; SW_IC3236_2pin_SMD_P6mm
SW10: 0/J; SW_IC3236_2pin_SMD_P6mm
SW11: LEFT; SW_IC3236_2pin_SMD_P6mm
SW12: MODE; SW_IC3236_2pin_SMD_P6mm
SW13: RIGHT; SW_IC3236_2pin_SMD_P6mm
SW14: OK; SW_IC3236_2pin_SMD_P6mm
SW15: SS-12F23G4; SW_SS12F23G4
U1: Boost USB 0.9-5V / 5V (external)

Connections:
/3V3: C2.1, C5.1, J3.4, Q2.2 (S), Q3.2 (S), R8.1, R10.1, R11.1
/AA_RAW: BT1.1 (+), SW15.2 (COM)
/AA_SW: Q1.3 (D), SW15.3 (ON)
/COL1: J3.5, SW1.1, SW4.1, SW7.1
/COL2: J3.6, SW2.1, SW5.1, SW8.1, SW10.1
/COL3: J3.7, SW3.1, SW6.1, SW9.1, SW14.1
/COL4: J3.8, SW11.1, SW12.1, SW13.1
/DIG1_EN: Q2.1 (G), R10.2, R17.1
/DIG2_EN: Q3.1 (G), R11.2, R18.1
/DS_DIG1: DS1.10 (CA1), Q2.3 (D)
/DS_DIG2: DS1.5 (CA2), Q3.3 (D)
/LED_RG: D1.1 (K), D2.2 (A), J2.12
/ROW1: R13.2, SW1.2, SW2.2, SW3.2, SW11.2
/ROW2: R14.2, SW4.2, SW5.2, SW6.2, SW13.2
/ROW3: R15.2, SW7.2, SW8.2, SW9.2, SW12.2
/ROW4: R16.2, SW10.2, SW14.2
/SEG_A: DS1.3 (A), R1.1
/SEG_B: DS1.9 (B), R2.1
/SEG_C: DS1.8 (C), R3.1
/SEG_D: DS1.6 (D), R4.1
/SEG_E: DS1.7 (E), R5.1
/SEG_F: DS1.4 (F), R6.1
/SEG_G: DS1.1 (G), R7.1
/USB_5V: J4.1 (5V), J6.1 (PLUS), U1.3 (USB_VBUS)
/VIN_AA: C1.1, J5.1 (PLUS), Q1.2 (S), U1.1 (IN+)
GND: BT1.2 (-), C1.2, C2.2, C5.2, J2.3, J2.4, J3.2, J4.2 (GND), J5.2 (GND), J6.2 (GND), Q1.1 (G), R9.2, U1.2 (IN-), U1.4 (USB_GND)
unnamed: D1.2 (A), R8.2
unnamed: D2.1 (K), D4.2 (A)
unnamed: D4.1 (K), R9.1
unnamed: J2.1, R1.2
unnamed: J2.2, R2.2
unnamed: J2.5, R3.2
unnamed: J2.6, R4.2
unnamed: J2.7, R5.2
unnamed: J2.8, R6.2
unnamed: J2.9, R7.2
unnamed: J2.10, R17.2
unnamed: J2.11, R18.2
unnamed: J3.9, R13.1
unnamed: J3.10, R14.1
unnamed: J3.11, R15.1
unnamed: J3.12, R16.1

Notes on the sheet:
VCC
P0.29
P1.06
3. BÀN PHÍM MA TRẬN 4×4 (14 phím, 8 GPIO)
P0.17
GND
P1.15
RST
P0.10
P1.13
P0.06
P0.31
P0.20
P0.24
4. HIỂN THỊ: LED 7 đoạn 2 số 3261BS (anode chung) + đèn đỏ/xanh 1 chân
P0.09
P0.22
P1.04
2. CHÂN HÀN SuperMini nRF52840 (J2 = hàng chân trái, J3 = hàng chân phải; chân 1 ở đầu USB)
P0.11
P1.00
P0.08
P0.02
P1.11
1. NGUON 2xAA: BT1 -> SW15 -> Q1 -> J5 -> external USB boost -> J6 -> J4 -> SuperMini

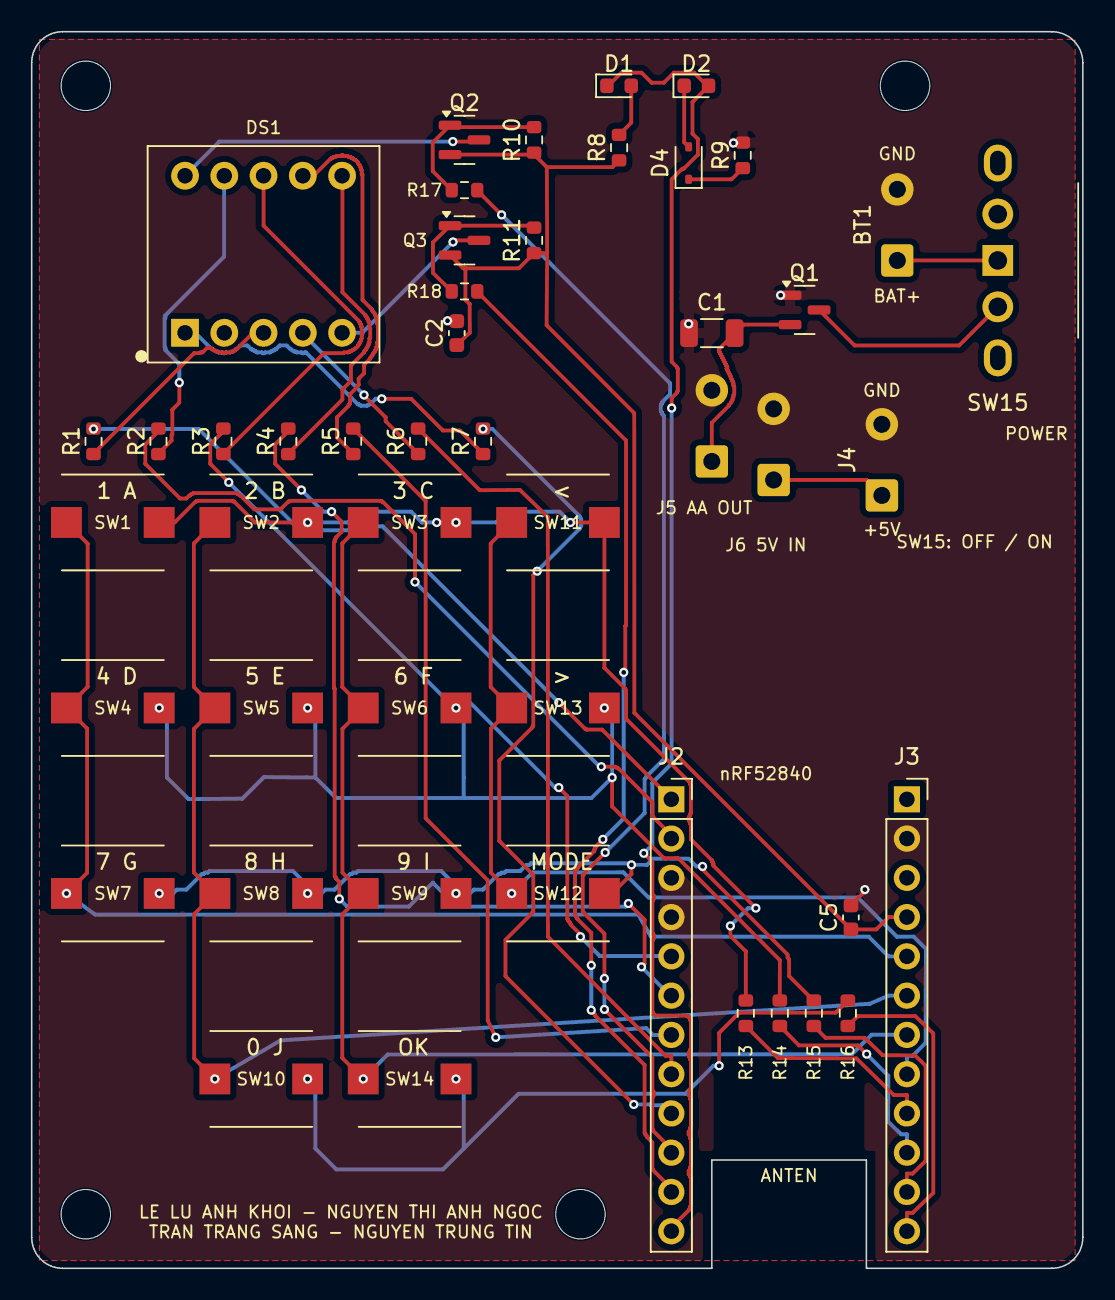
[picture p33: board ARS_clicker_nRF.kicad_pcb from above]

Board: 2 copper layers, 68.0 x 80.0 mm, 52 parts (0 on the bottom side), 42 nets.

Other parts of the board:
H1, H2, H3, H4: MountingHole_3.2mm_M3
