Rubydangoday/Project_IOT_clicker/firmware/ARS_remote_v3_17/ARS_remote_v3_17.ino

#include "board_pins.h"
#include "keypad.h"
#include "display.h"
#include "status_led.h"
#include "ars_ble.h"

#include <Arduino.h>
#include <nrf_gpio.h>
#include <nrf.h>
#include <Adafruit_LittleFS.h>
#include <InternalFileSystem.h>

using namespace Adafruit_LittleFS_Namespace;

// V3.17: experimental advertising with durable exact transaction results.
// Physical GPIO/keypad/storage stay compatible with V3.10.
static constexpr uint8_t DEFAULT_ROOM = 1;
static constexpr uint16_t TEST_BATTERY_MV = 0;   // TODO: ADC battery measurement (step 2)

static constexpr uint32_t ACK_LISTEN_MS = 2500;
static constexpr uint8_t MAX_ATTEMPTS = 6;
static constexpr uint16_t BACKOFF_MS[3][2] = {{100,300},{200,600},{400,1200}};
static bool loggedIn=false,loginWanted=false,wasReady=false;
static uint32_t errorUntilMs=0;
static uint32_t firstTxMs=0;
static constexpr uint32_t IDLE_TIMEOUT_MS=30000;
static constexpr uint32_t IDLE_POLL_MS=20;
static uint32_t lastActivityMs=0;
static bool idleSleeping=false;
static bool suppressKeysUntilRelease=false;

// Room/seat are typed by the student (MODE) and kept in flash.
static uint8_t gRoom = DEFAULT_ROOM;
static uint8_t gSeat = 0;                          // 0 = not set yet

static uint8_t seqNo = 0;
static uint8_t currentQuestion = 0;
static uint8_t selectedAnswer = 0; // 0 none, 1..10 A..J

// STATE describes the teacher's current question (position, not database ID).
// The backend remains authoritative if a close races with an answer in flight.
static uint8_t serverStateQuestion = 0;
static uint8_t serverOptionCount = 0;
static bool serverQuestionOpen = false;
static bool serverStateKnown = false;

static void clearQuestionState() {
    currentQuestion=serverStateQuestion=serverOptionCount=selectedAnswer=0;
    serverQuestionOpen=false;
    serverStateKnown=false;
}

static bool questionAnswerable() {
    return currentQuestion>=1 && currentQuestion<=99 &&
           currentQuestion==serverStateQuestion && serverQuestionOpen &&
           serverOptionCount>=1 && serverOptionCount<=10;
}

// ----------------------- pending TX / retry state -----------------------
enum PendingKind : uint8_t {
    PENDING_NONE = 0,
    PENDING_LOGIN,
    PENDING_ANSWER
};

struct PendingTx {
    PendingKind kind = PENDING_NONE;
    uint8_t question = 0;
    uint8_t seq = 0;
    uint8_t answer = 0;
    uint8_t attempts = 0;
    uint32_t deadlineMs = 0;
};

static PendingTx pending;
static bool retryBackoffArmed = false;
static uint32_t retryBackoffUntilMs = 0;

static uint8_t nextSeq() {
    seqNo = static_cast<uint8_t>(seqNo + 1);
    return seqNo;
}

static char answerLetter(uint8_t code) {
    if (code < 1 || code > 10) return '?';
    return static_cast<char>('A' + code - 1);
}

static bool optionKnownInvalid(uint8_t answerCode) {
    if (serverStateQuestion == 0 || serverOptionCount == 0) return false;
    if (currentQuestion != serverStateQuestion) return false;
    return answerCode < 1 || answerCode > serverOptionCount;
}

static void reportLocalInvalidOption(uint8_t answerCode) {
    Serial.print("LOCAL REJECT: answer ");
    Serial.print(answerLetter(answerCode));
    Serial.print(" invalid for q=");
    Serial.print(currentQuestion);
    Serial.print("; allowed=A..");
    Serial.println(answerLetter(serverOptionCount));
    statusLedFlash(STATUS_RED, 500);
    errorUntilMs=millis()+1800;
}

static const char* resultStatusName(uint8_t status) {
    switch (status) {
        case 0:  return "OK";
        case 1:  return "BAD_OPTION";
        case 2:  return "QUESTION_CLOSED";
        case 3:  return "NOT_LOGGED_IN";
        case 4:  return "NO_SESSION";
        case 5:  return "QUESTION_NOT_OPEN";
        case 6:  return "LATE";
        case 7:  return "NO_CHANGE";
        case 8:  return "UNKNOWN_SEAT";
        case 9:  return "MAPPING_MISMATCH";
        case 10: return "ID_MISMATCH";
        case 11: return "SEAT_TAKEN";
        case 12: return "MAC_BOUND";
        case 13: return "WRONG_LINK";
        case 14: return "MALFORMED";
        default: return "SERVER_REJECT";
    }
}

// ----------------------- identity (room / seat) in flash -----------------------
static const char* ID_FILE = "/ars_id.bin";

static void loadIdentity() {
    InternalFS.begin();
    File f(InternalFS);
    if (f.open(ID_FILE, FILE_O_READ)) {
        uint8_t b[4] = {0};
        if (f.read(b, sizeof(b)) == sizeof(b) && b[0] == 0xA5 && b[3] == (uint8_t)(b[0] ^ b[1] ^ b[2])) {
            gRoom = b[1] ? b[1] : DEFAULT_ROOM;
            gSeat = (b[2] >= 1 && b[2] <= 99) ? b[2] : 0;
        }
        f.close();
    }
}

static void saveIdentity() {
    const uint8_t b[4] = { 0xA5, gRoom, gSeat, (uint8_t)(0xA5 ^ gRoom ^ gSeat) };
    InternalFS.remove(ID_FILE);
    File f(InternalFS);
    if (f.open(ID_FILE, FILE_O_WRITE)) {
        f.write(b, sizeof(b));
        f.close();
    }
}

// ----------------------- keypad entry of seat / room -----------------------
enum UiMode : uint8_t { UI_NORMAL = 0, UI_ENTER_SEAT, UI_ENTER_ROOM };
static UiMode uiMode = UI_NORMAL;
static uint8_t entryValue = 0;
static bool entryTyped = false;

static void showEntry() {
    displaySetMode(uiMode==UI_ENTER_ROOM?DISP_ROOM:DISP_SEAT,entryValue,entryTyped);
}

// uint8_t parameter: the Arduino builder puts auto-prototypes above the enum declaration.
static void startEntry(uint8_t mode) {
    uiMode = static_cast<UiMode>(mode);
    entryValue = (mode == UI_ENTER_SEAT) ? gSeat : gRoom;
    entryTyped = false;
    showEntry();
    Serial.println(mode == UI_ENTER_SEAT
        ? "ENTER SEAT: type 1..99, OK = save + LOGIN, MODE = room, LEFT = cancel"
        : "ENTER ROOM: type 1..99, OK = save, MODE = seat, LEFT = cancel");
}

static void printPacket(const char* label,
                        uint8_t type,
                        uint8_t q,
                        uint8_t seq,
                        uint8_t ans) {
    Serial.print(label);
    Serial.print(" type=");Serial.print(type);
    Serial.print(" room=");
    Serial.print(gRoom);
    Serial.print(" seat=");
    Serial.print(gSeat);
    Serial.print(" q=");
    Serial.print(q);
    Serial.print(" seq=");
    Serial.print(seq);
    Serial.print(" ans=");
    if (ans == 0) Serial.print('-');
    else Serial.print(answerLetter(ans));
    Serial.println();
}

static void transmitPending(bool retry) {
    if (pending.kind == PENDING_NONE) return;

    pending.attempts++;
    uint8_t type=pending.kind==PENDING_LOGIN?ArsBle::TYPE_LOGIN:ArsBle::TYPE_ANSWER;
    bool sent=ArsBle::sendPacket(type,gRoom,gSeat,pending.question,pending.seq,pending.answer,TEST_BATTERY_MV);
    printPacket(sent?(retry?"RETRY QUEUED":"TX QUEUED"):"TX QUEUE FAILED",
                type,pending.question,pending.seq,pending.answer);
    if(pending.attempts==1) firstTxMs=millis();
    pending.deadlineMs=millis()+ACK_LISTEN_MS;

}

static void beginLogin() {
    loggedIn=false;
    loginWanted=true;
    if (gSeat == 0) {
        Serial.println("LOGIN skipped: seat not set (press MODE, type seat, OK)");
        startEntry(UI_ENTER_SEAT);
        return;
    }
    if(!ArsBle::ready()) return;
    loginWanted=false;
    pending.kind = PENDING_LOGIN;
    pending.question = 0;
    pending.seq = nextSeq();
    pending.answer = 0;
    pending.attempts = 0;
    retryBackoffArmed = false;

    statusLedSet(STATUS_OFF);
    transmitPending(false);
}

static void beginAnswer() {
    if(!ArsBle::ready() || !loggedIn) {
        Serial.println("NOT READY: wait for BLE + exact LOGIN ACK; MODE -> OK retries LOGIN");
        errorUntilMs=millis()+1800;
        statusLedFlash(STATUS_RED,700);
        return;
    }
    if(!questionAnswerable()) {
        Serial.println("OK ignored: wait for the teacher to open the current question");
        selectedAnswer=0;
        statusLedFlash(STATUS_RED,400);
        return;
    }
    if (selectedAnswer == 0) {
        Serial.println("OK ignored: no answer selected");
        statusLedFlash(STATUS_RED, 400);
        return;
    }

    if (pending.kind != PENDING_NONE) {
        Serial.println("OK ignored: waiting for server ACK");
        statusLedFlash(STATUS_RED, 180);
        return;
    }

    // Validate against the options of the automatically selected question.
    if (optionKnownInvalid(selectedAnswer)) {
        reportLocalInvalidOption(selectedAnswer);
        selectedAnswer = 0;
        displaySetNumber(currentQuestion);
        return;
    }

    pending.kind = PENDING_ANSWER;
    pending.question = currentQuestion;
    pending.seq = nextSeq();
    pending.answer = selectedAnswer;
    pending.attempts = 0;
    retryBackoffArmed = false;

    statusLedSet(STATUS_OFF);
    transmitPending(false);
}

static void finishLoginAck(uint8_t seq,uint8_t status) {
    if(pending.kind!=PENDING_LOGIN || pending.seq!=seq) return;
    loggedIn=(status==0);
    Serial.print(loggedIn?"ACK LOGIN EXACT: ":"NACK LOGIN EXACT: ");
    Serial.println(resultStatusName(status));
    ArsBle::reportOutcome(status,uint32_t(millis()-firstTxMs));
    ArsBle::finishTransaction();
    pending.kind=PENDING_NONE;retryBackoffArmed=false;
    if(loggedIn) statusLedFlash(STATUS_GREEN,350);
    else {errorUntilMs=millis()+1800;statusLedFlash(STATUS_RED,900);}
}

static void finishAnswerAck(uint8_t q, uint8_t seq, uint8_t ans, uint8_t status) {
    if (pending.kind != PENDING_ANSWER) return;
    if (q != pending.question || seq != pending.seq || ans != pending.answer) {
        Serial.print("Ignore old/other RESULT q=");
        Serial.print(q);
        Serial.print(" seq=");
        Serial.print(seq);
        Serial.print(" ans=");
        Serial.print(answerLetter(ans));
        Serial.print(" status=");
        Serial.println(resultStatusName(status));
        return;
    }

    if (status == 0) {
        Serial.print("ACK ANSWER EXACT: server confirmed q=");
        Serial.print(q);
        Serial.print(" seq=");
        Serial.print(seq);
        Serial.print(" ans=");
        Serial.println(answerLetter(ans));
        statusLedFlash(STATUS_GREEN, 450);
    } else {
        Serial.print("NACK ANSWER EXACT: server rejected q=");
        Serial.print(q);
        Serial.print(" seq=");
        Serial.print(seq);
        Serial.print(" ans=");
        Serial.print(answerLetter(ans));
        Serial.print(" reason=");
        Serial.println(resultStatusName(status));
        errorUntilMs=millis()+1800;
        if(status==3 || status==4) loggedIn=false;
        statusLedFlash(STATUS_RED, 700);
    }

    Serial.print("RESULT elapsed_ms=");Serial.println((uint32_t)(millis()-firstTxMs));
    // Accepted or rejected, the server has definitively processed this exact
    // transaction. Do not retry it. Force a fresh choice for the next OK press.
    ArsBle::reportOutcome(status,uint32_t(millis()-firstTxMs));
    ArsBle::finishTransaction();
    pending.kind = PENDING_NONE;
    retryBackoffArmed = false;
    selectedAnswer = 0;
    displaySetNumber(currentQuestion);
}

static void processDownlink() {
    uint8_t loginSeq=0,loginStatus=0;
    if(ArsBle::takeLoginAck(loginSeq,loginStatus)) finishLoginAck(loginSeq,loginStatus);

    uint8_t ackQuestion = 0;
    uint8_t ackSeq = 0;
    uint8_t ackAnswer = 0;
    uint8_t ackStatus = 0;
    if (ArsBle::takeAnswerAck(ackQuestion, ackSeq, ackAnswer, ackStatus)) {
        finishAnswerAck(ackQuestion, ackSeq, ackAnswer, ackStatus);
    }

    uint8_t serverQ = 0;
    uint8_t serverOptions = 0;
    bool serverOpen = false;
    if (ArsBle::takeStateUpdate(serverQ, serverOpen, serverOptions)) {
        // Clear only the unsent choice. pending.question/seq/answer must stay
        // immutable through a question switch until its exact result or timeout.
        if(serverQ!=serverStateQuestion || serverOpen!=serverQuestionOpen ||
           serverOptions!=serverOptionCount) selectedAnswer=0;
        serverStateQuestion = serverQ;
        serverStateKnown = serverQ<=99;
        serverQuestionOpen = serverOpen;
        serverOptionCount = serverOptions;
        currentQuestion = (serverQ>=1 && serverQ<=99) ? serverQ : 0;
        Serial.print("SERVER STATE q=");
        Serial.print(serverQ);
        Serial.print(" open=");
        Serial.print(serverOpen ? 1 : 0);
        Serial.print(" options=");
        Serial.println(serverOptions);
    }

    uint64_t mask = 0;
    if (ArsBle::takeOpenMask(mask)) {
        Serial.print("SERVER OPENMASK 0x");
        const uint32_t hi = static_cast<uint32_t>(mask >> 32);
        const uint32_t lo = static_cast<uint32_t>(mask & 0xFFFFFFFFu);
        if (hi) {
            Serial.print(hi, HEX);
            Serial.print("_");
            Serial.println(lo, HEX);
        } else {
            Serial.println(lo, HEX);
        }
    }
}

static void processRetry() {
    if (pending.kind == PENDING_NONE) return;
    const uint32_t now = millis();
    if ((int32_t)(now - pending.deadlineMs) < 0) return;

    if (pending.attempts >= MAX_ATTEMPTS) {
        Serial.println("ACK TIMEOUT: outcome UNKNOWN; verify web before a new answer");
        errorUntilMs=millis()+1800;
        selectedAnswer=0;
        ArsBle::reportOutcome(256,uint32_t(millis()-firstTxMs));
        ArsBle::finishTransaction();
        pending.kind = PENDING_NONE;
        retryBackoffArmed = false;
        statusLedFlash(STATUS_RED, 900);
        return;
    }

    // Short non-blocking retry for one remote; retain the exact transaction identity.
    if (!retryBackoffArmed) {
        const uint8_t k = (pending.attempts >= 1 && pending.attempts <= 3) ? pending.attempts - 1 : 2;
        const uint32_t span = BACKOFF_MS[k][1] - BACKOFF_MS[k][0] + 1;
        const uint16_t backoff = BACKOFF_MS[k][0] + static_cast<uint16_t>(random(span));
        retryBackoffUntilMs = now + backoff;
        retryBackoffArmed = true;
        Serial.print("No ACK yet -> random backoff ");
        Serial.print(backoff);
        Serial.println(" ms before retry same seq");
        return;
    }

    if ((int32_t)(now - retryBackoffUntilMs) < 0) return;

    retryBackoffArmed = false;
    transmitPending(true); // IMPORTANT: same seq, so server can de-duplicate
}

static bool isAnswerKey(KeyId key) {
    return key >= KEY_1_A && key <= KEY_0_J;
}

static uint8_t answerCodeFromKey(KeyId key) {
    return static_cast<uint8_t>(key);
}

static void handleEntryKey(KeyId key) {
    if (isAnswerKey(key)) {                          // 1/A..9/I = 1..9, 0/J = 0
        const uint8_t d = (key == KEY_0_J) ? 0 : static_cast<uint8_t>(key);
        entryValue = entryTyped ? static_cast<uint8_t>((entryValue * 10 + d) % 100) : d;
        entryTyped = true;
        showEntry();
        return;
    }
    switch (key) {
        case KEY_MODE:
            startEntry(uiMode == UI_ENTER_SEAT ? UI_ENTER_ROOM : UI_ENTER_SEAT);
            break;
        case KEY_LEFT:                               // cancel
            uiMode = UI_NORMAL;
            Serial.println("Entry cancelled");
            displaySetNumber(currentQuestion);
            if (gSeat == 0) startEntry(UI_ENTER_SEAT);
            break;
        case KEY_OK:
            if (entryValue < 1 || entryValue > 99) {
                Serial.println("Entry rejected: use 1..99");
                statusLedFlash(STATUS_RED, 500);
                break;
            }
            if (uiMode == UI_ENTER_ROOM) {
                gRoom = entryValue;
                loggedIn=false;loginWanted=true;clearQuestionState();
                saveIdentity();
                ArsBle::setIdentity(gRoom, gSeat);
                Serial.print("Room saved: ");
                Serial.println(gRoom);
                statusLedSet(STATUS_OFF);
                startEntry(UI_ENTER_SEAT);           // continue with the seat
            } else {
                gSeat = entryValue;
                selectedAnswer=0;
                saveIdentity();
                ArsBle::setIdentity(gRoom, gSeat);
                Serial.print("Seat saved: ");
                Serial.println(gSeat);
                uiMode = UI_NORMAL;
                displaySetNumber(currentQuestion);
                beginLogin();                        // OK without typing = LOGIN again (old MODE behaviour)
            }
            break;
        default:
            break;
    }
}

static void handleKey(KeyId key) {
    errorUntilMs=0;
    if (uiMode != UI_NORMAL && key != KEY_MULTI) {
        handleEntryKey(key);
        return;
    }
    if (key == KEY_MULTI) {
        Serial.println("KEY_MULTI: more than one key detected");
        statusLedFlash(STATUS_RED, 600);
        return;
    }

    if (isAnswerKey(key)) {
        if (pending.kind != PENDING_NONE) {
            Serial.println("Answer key ignored: waiting for server ACK");
            return;
        }
        if(!ArsBle::ready() || !loggedIn || !questionAnswerable()) {
            selectedAnswer=0;
            Serial.println("Answer key ignored: wait for LOGIN and an open current question");
            statusLedFlash(STATUS_RED,300);
            return;
        }

        const uint8_t candidate = answerCodeFromKey(key);
        if (optionKnownInvalid(candidate)) {
            reportLocalInvalidOption(candidate);
            return;
        }

        selectedAnswer = candidate;
        Serial.print("Selected answer: ");
        Serial.println(answerLetter(selectedAnswer));
        displaySetMode(DISP_ANSWER,selectedAnswer,true);
        return;
    }

    switch (key) {
        case KEY_LEFT:
        case KEY_RIGHT:
            Serial.println("AUTO QUESTION: LEFT/RIGHT do not change the teacher's question");
            break;

        case KEY_MODE:
            if (pending.kind != PENDING_NONE) {
                Serial.println("MODE ignored: waiting for server ACK");
                break;
            }
            selectedAnswer=0;
            startEntry(UI_ENTER_SEAT);               // MODE -> type seat (MODE again -> room), OK -> LOGIN
            break;

        case KEY_OK:
            beginAnswer();
            break;

        default:
            break;
    }
}

void setup() {
    nrf_gpio_cfg_output(BoardPins::EXT_VCC);
    nrf_gpio_pin_set(BoardPins::EXT_VCC);

    Serial.begin(115200);
    const uint32_t serialWaitStart = millis();
    while (!Serial && (uint32_t)(millis() - serialWaitStart) < 3000) {
        delay(10);
    }

    displayBegin();
    statusLedBegin();
    keypadBegin();

    // Proven hardware self-test.
    displaySetNumber(88);
    statusLedSet(STATUS_RED);
    uint32_t t0 = millis();
    while ((uint32_t)(millis() - t0) < 500) displayUpdate();

    statusLedSet(STATUS_GREEN);
    t0 = millis();
    while ((uint32_t)(millis() - t0) < 500) displayUpdate();

    statusLedSet(STATUS_OFF);
    displaySetNumber(currentQuestion);

    Serial.println();
    Serial.println("ARS Remote V3.17 ADV experimental / letter answers");
    Serial.println("BLE advertising: A6 frames, random transaction token, durable backend results");
    Serial.println("GPIO: physical nRF52840 pins via nrf_gpio");

    // Per-device pseudo-random seed for retry backoff. Different remotes have
    // different DEVICEID values, so simultaneous retries spread out naturally.
    randomSeed(static_cast<uint32_t>(micros()) ^ NRF_FICR->DEVICEID[0] ^ NRF_FICR->DEVICEID[1]);
    seqNo = static_cast<uint8_t>(random(256));      // random start: a reboot rarely reuses a recent seq

    loadIdentity();
    Serial.print("Identity from flash: room=");
    Serial.print(gRoom);
    Serial.print(" seat=");
    Serial.println(gSeat);

    ArsBle::begin(gRoom, gSeat);
    beginLogin();                                    // seat 0 -> asks for the seat first

    Serial.println("Ready: question follows teacher; A..J select, OK sends, MODE = seat/room.");
    Serial.println("Green = accepted exact result. Red = server NACK or ACK timeout.");
    lastActivityMs=millis();
}

static void processConnection() {
    bool connected=ArsBle::ready();
    if(wasReady && !connected) {
        Serial.println("ADV STATE LOST/CHANGED: outcome may be UNKNOWN; no automatic answer replay");
        if(pending.kind!=PENDING_NONE) {errorUntilMs=millis()+1800;ArsBle::reportOutcome(257,uint32_t(millis()-firstTxMs));}
        ArsBle::finishTransaction();
        pending.kind=PENDING_NONE;retryBackoffArmed=false;
        selectedAnswer=0;loggedIn=false;loginWanted=true;
        clearQuestionState();
        statusLedFlash(STATUS_RED,800);
    }
    if(!wasReady && connected) {Serial.println("ADV STATE READY");loginWanted=true;}
    wasReady=connected;
    if(connected && loginWanted && pending.kind==PENDING_NONE && uiMode==UI_NORMAL && gSeat!=0) beginLogin();
}
static void renderUi() {
    // Editing has priority so room/seat can be configured even while disconnected.
    if(uiMode!=UI_NORMAL) {
        displaySetMode(uiMode==UI_ENTER_ROOM?DISP_ROOM:DISP_SEAT,entryValue);return;
    }
    if(errorUntilMs && (int32_t)(millis()-errorUntilMs)<0) {displaySetMode(DISP_ERROR);return;}
    if(!ArsBle::ready()) {displaySetMode(DISP_BLUETOOTH);return;}
    if(pending.kind!=PENDING_NONE) {displaySetMode(DISP_WAIT);return;}
    if(!loggedIn) {displaySetMode(DISP_LOGIN);return;}
    if(!questionAnswerable()) {
        displaySetMode(currentQuestion && !serverQuestionOpen ? DISP_CLOSED : DISP_SYNC);return;
    }
    if(selectedAnswer) displaySetMode(DISP_ANSWER,selectedAnswer);
    else displaySetMode(DISP_QUESTION,currentQuestion);
}

static void leaveIdle(const char* reason) {
    if(!idleSleeping) return;
    idleSleeping=false;
    displaySetSleeping(false);
    lastActivityMs=millis();
    Serial.print("IDLE WAKE: ");Serial.println(reason);
}

static void processUserInput(KeyId key) {
    const bool active=keypadIsActive() || key!=KEY_NONE;
    if(active) lastActivityMs=millis();
    if(idleSleeping && active) {
        leaveIdle("key; release before next action");
        // Suppress even an unsettled raw press; never let its later debounced
        // event become an answer, OK, or MODE action after waking.
        suppressKeysUntilRelease=true;
    }
    if(suppressKeysUntilRelease) {
        if(!active) suppressKeysUntilRelease=false;
        return;
    }
    if(key!=KEY_NONE) handleKey(key);
}

static void processIdlePower() {
    const uint32_t now=millis();
    const bool errorVisible=errorUntilMs && (int32_t)(now-errorUntilMs)<0;
    // Unknown STATE and an open but malformed question must never mean closed.
    // Require a continuous quiet, eligible interval; HELLO and duplicate closed
    // STATE snapshots do not count as user activity.
    const bool eligible=ArsBle::ready() && loggedIn && !loginWanted &&
        serverStateKnown && !serverQuestionOpen && uiMode==UI_NORMAL &&
        pending.kind==PENDING_NONE && !retryBackoffArmed && !errorVisible &&
        !statusLedBusy() && !keypadIsActive() && !suppressKeysUntilRelease;
    if(!eligible) {
        leaveIdle(!ArsBle::ready()?"BLE not ready":
                  serverQuestionOpen?"question open":"activity or state changed");
        lastActivityMs=now;
        return;
    }
    if(!idleSleeping && (uint32_t)(now-lastActivityMs)>=IDLE_TIMEOUT_MS) {
        idleSleeping=true;
        displaySetSleeping(true);
        statusLedSet(STATUS_OFF);
        Serial.println("IDLE ENTER: display off, advertising scanner active");
    }
}

void loop() {
    ArsBle::update();
    processConnection();
    processDownlink();
    processRetry();
    const KeyId key=keypadGetPressedEvent();
    processUserInput(key);
    processIdlePower();
    renderUi();
    displayUpdate();
    statusLedUpdate();
    // Display/CPU idle only: scanner listens for STATE/ACK; a pending TX temporarily pauses RX.
    // Do not claim GATT-level radio power savings; measure the actual PCB.
    if(idleSleeping) delay(IDLE_POLL_MS);
}
