Rubydangoday/Project_IOT_clicker/(commit log)

2026-10-15 Project_IOT_clicker: hệ thống phản hồi lớp học dùng Remote nRF52840 (ARS V3.18 + Web/Cloud)
    Mã nguồn bản cuối, sắp xếp theo khối:
    - hardware/: dự án KiCad (sơ đồ, PCB, thư viện, Gerber), BOM, ảnh mạch
    - firmware/: Remote nRF52840 V3.17 (BLE advertising A6, LE 1M) + các phiên bản cũ
    - server/: bộ thu Bluetooth (bridge), bộ xử lý gói (ingest), common
    - database/: schema + migration 002–017
    - web/: PHP cho giáo viên, học sinh, phụ huynh, quản trị; đồng bộ Cloud
    - deploy/, tests/, tools/, docs/ (báo cáo, hướng dẫn sử dụng, phiên bản), samples/
    Đường dẫn trong script cài đặt, dịch vụ systemd, test v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
2026-10-15 README: thêm sơ đồ nguyên lý và PCB mặt trên, mặt dưới
2026-10-15 Thêm 2 ảnh mạch Remote thật vào hardware/images và README
